schlae/SynchroDriver/SynchroDriverD/SynchroDriverD.pdf

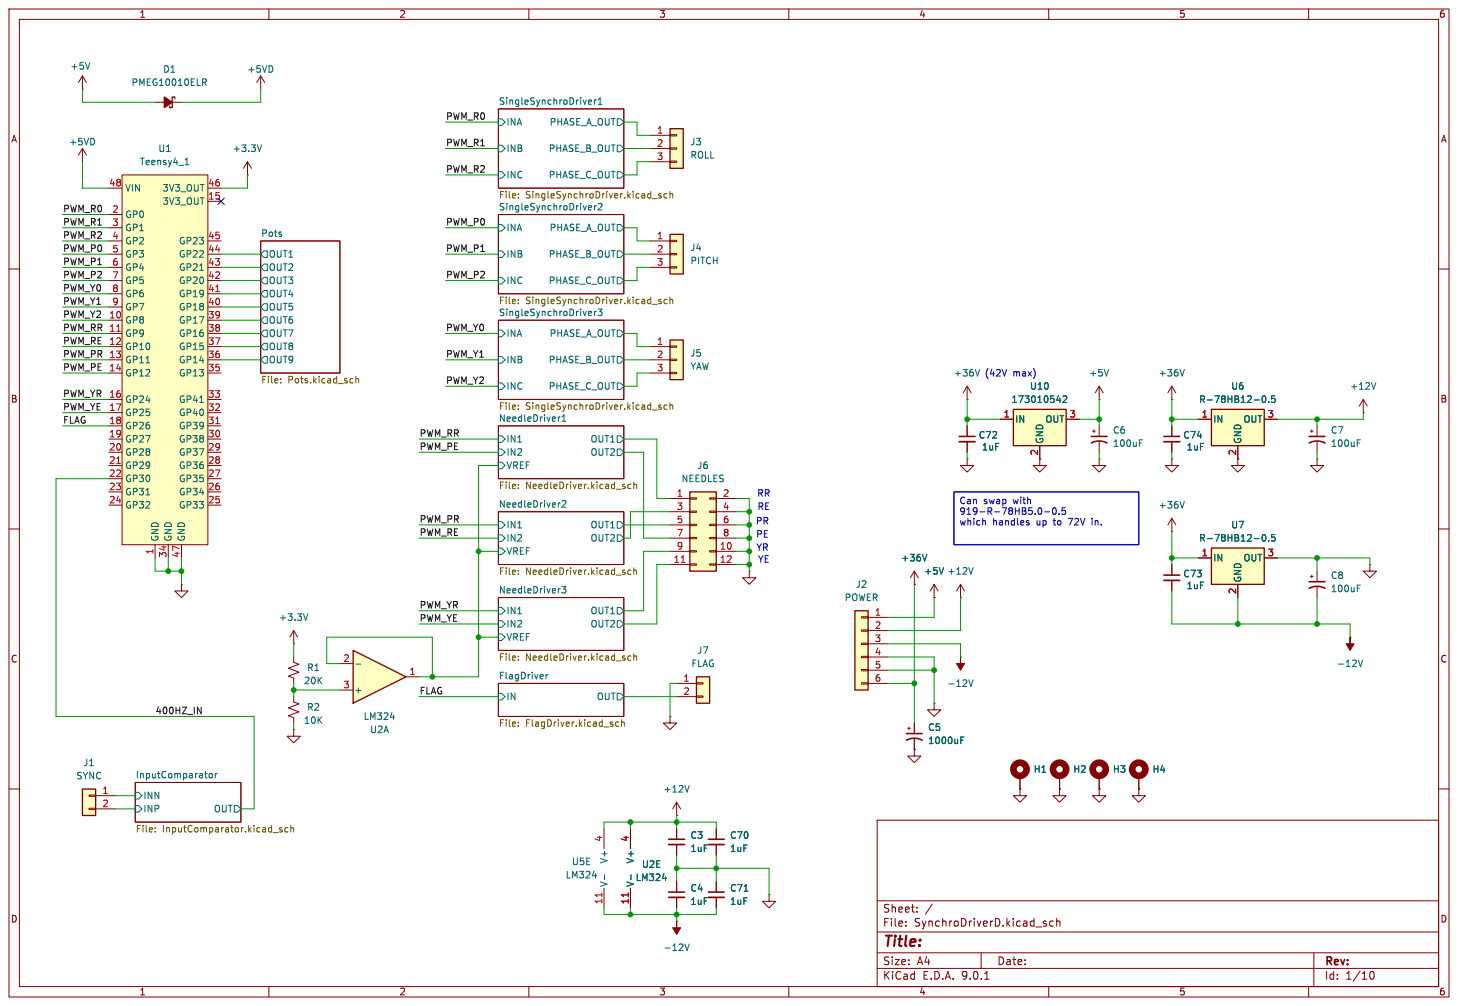
[picture p1: page 1]

919-R-78HB5.0-0.5 which handles up to 72V in. YR

Id: 1/10 Title: File: SynchroDriverD.kicad_sch Sheet: /

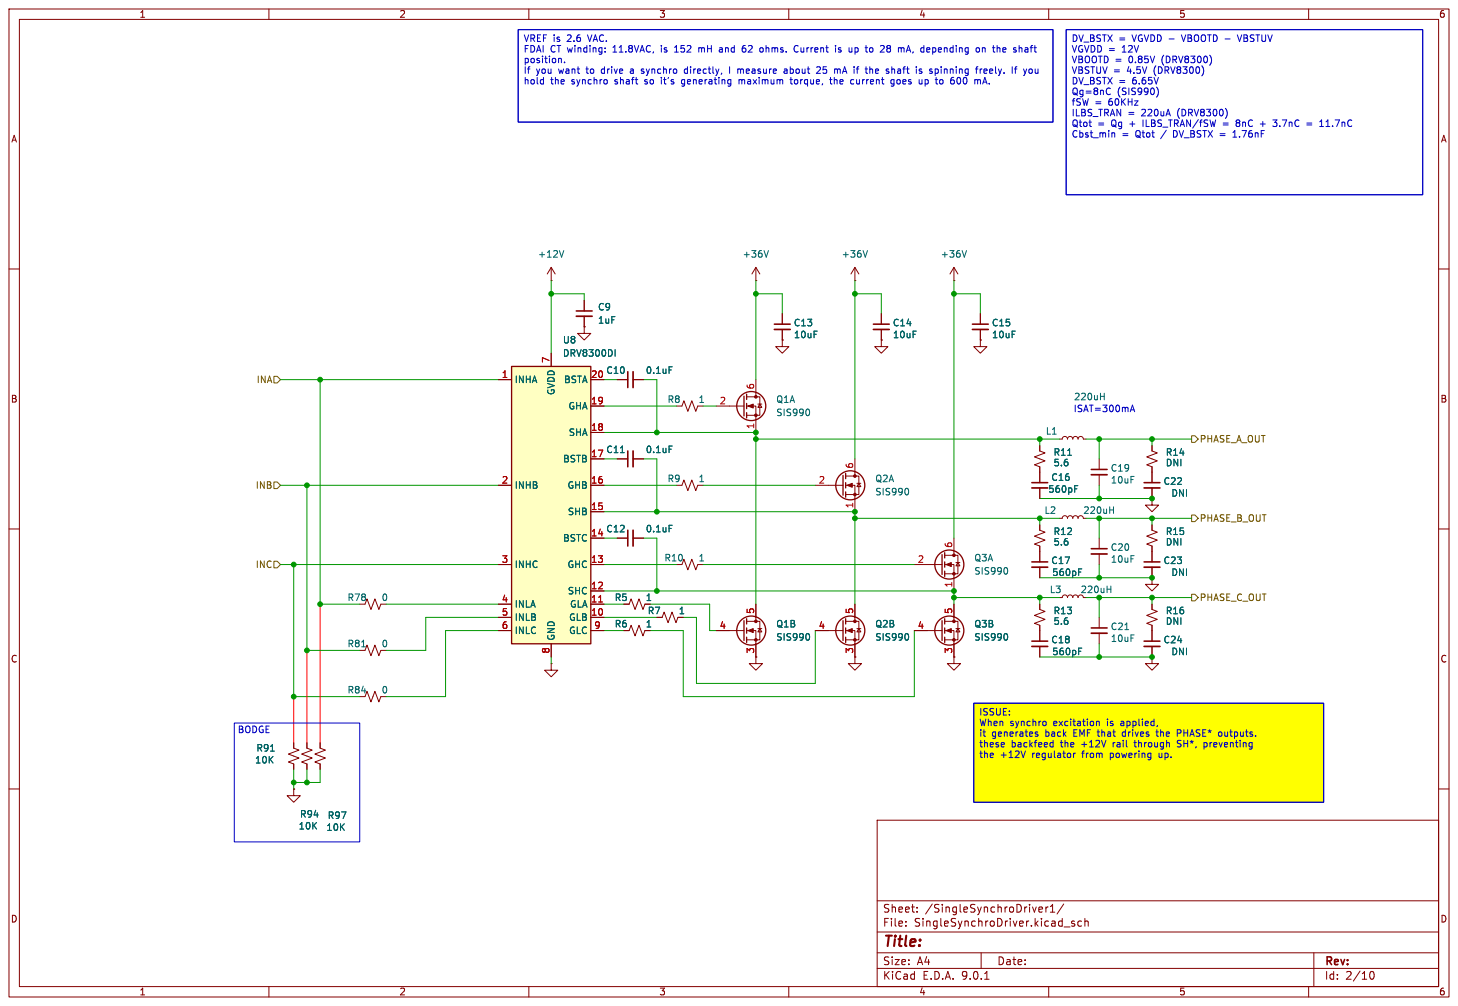
[picture p2: page 2]

8 BSTA 20 GHA 19 SHA 18 BSTB 17 GHB 16 SHB 15 BSTC 14 GHC 13 SHC 12 GLA 11 GLB 10 GLC 9 U8 DRV8300DI L1

8 BSTA 20 GHA 19 SHA 18 BSTB 17 GHB 16 SHB 15 BSTC 14 GHC 13 SHC 12 GLA 11 GLB 10 GLC 9 R94

these backfeed the +12V rail through SH*, preventing

Id: 2/10 Title: File: SingleSynchroDriver.kicad_sch Sheet: /SingleSynchroDriver1/

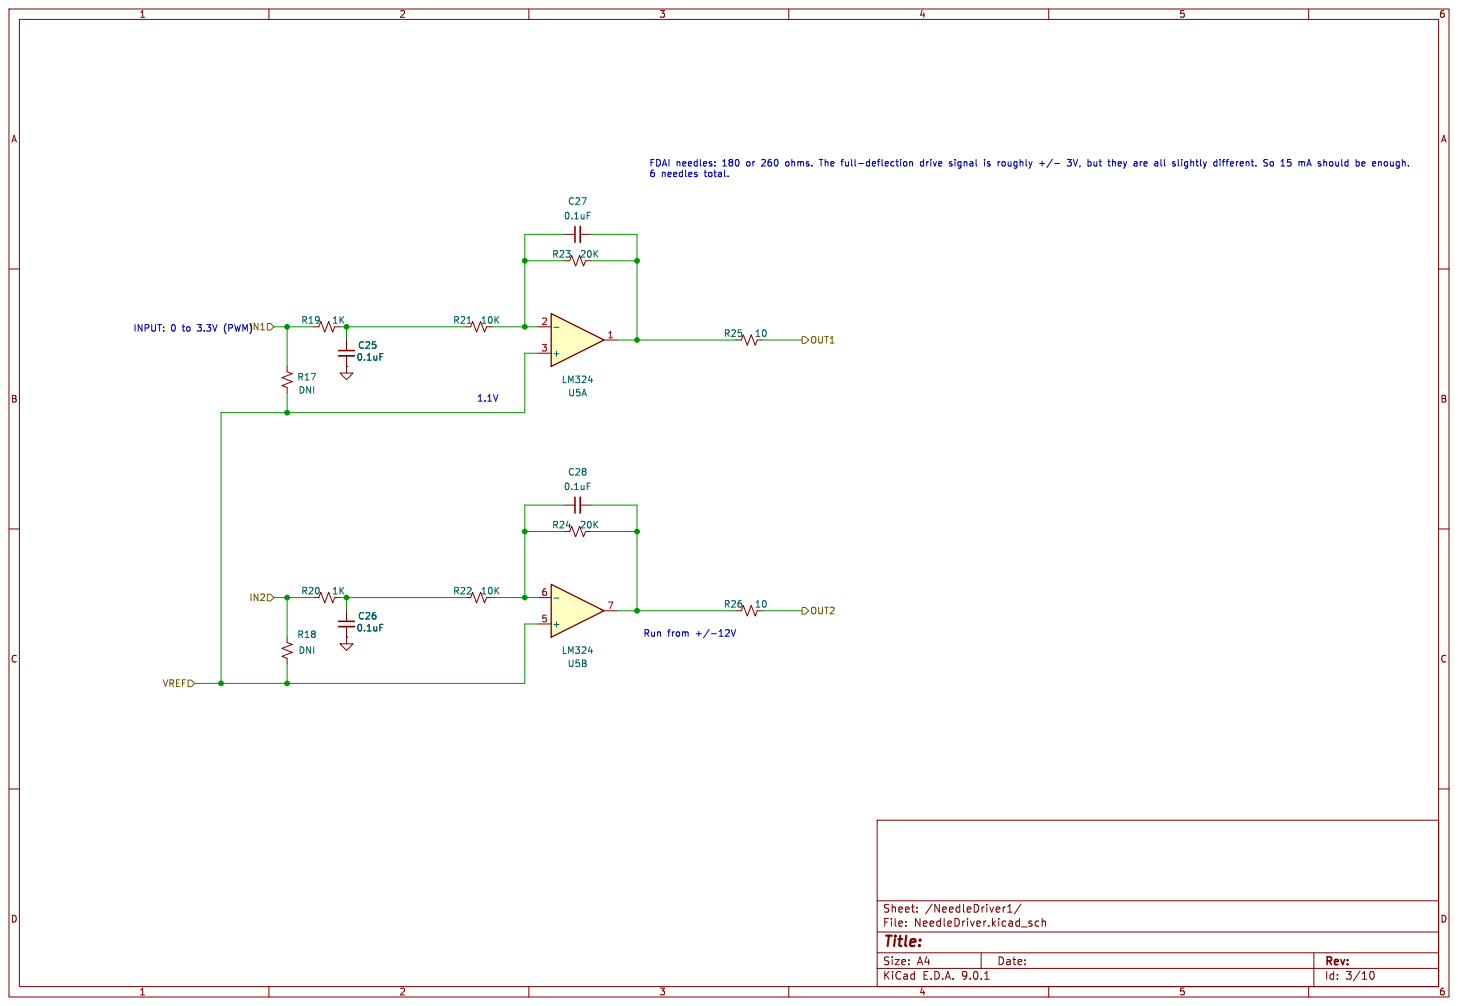
[picture p3: page 3]

Id: 3/10 Title: File: NeedleDriver.kicad_sch Sheet: /NeedleDriver1/

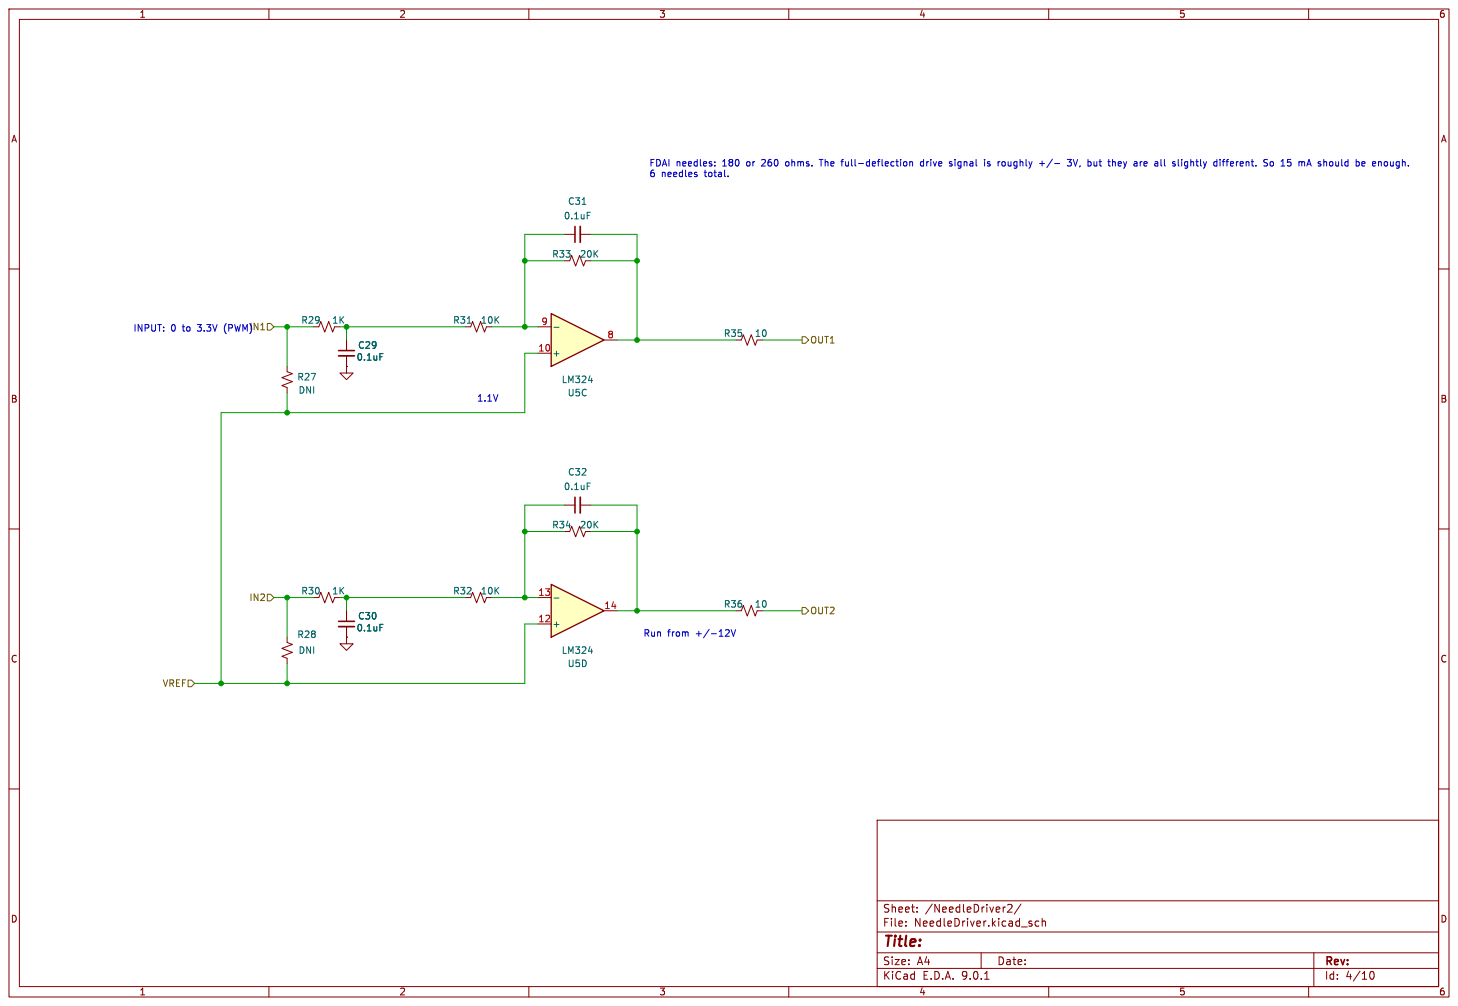
[picture p4: page 4]

Id: 4/10 Title: File: NeedleDriver.kicad_sch Sheet: /NeedleDriver2/

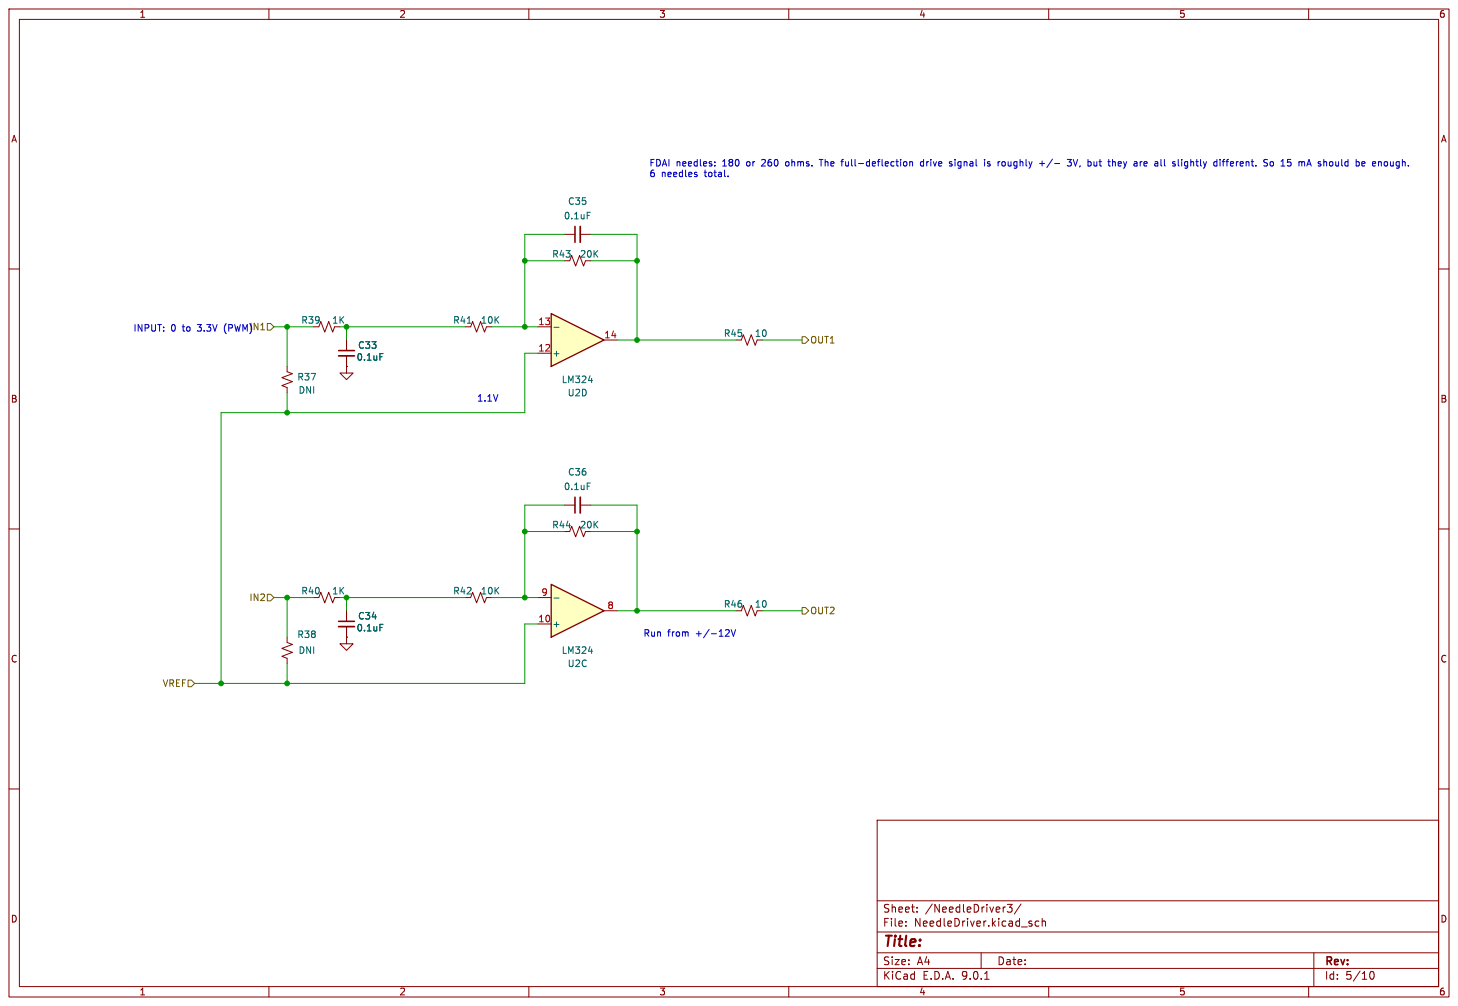
[picture p5: page 5]

Id: 5/10 Title: File: NeedleDriver.kicad_sch Sheet: /NeedleDriver3/

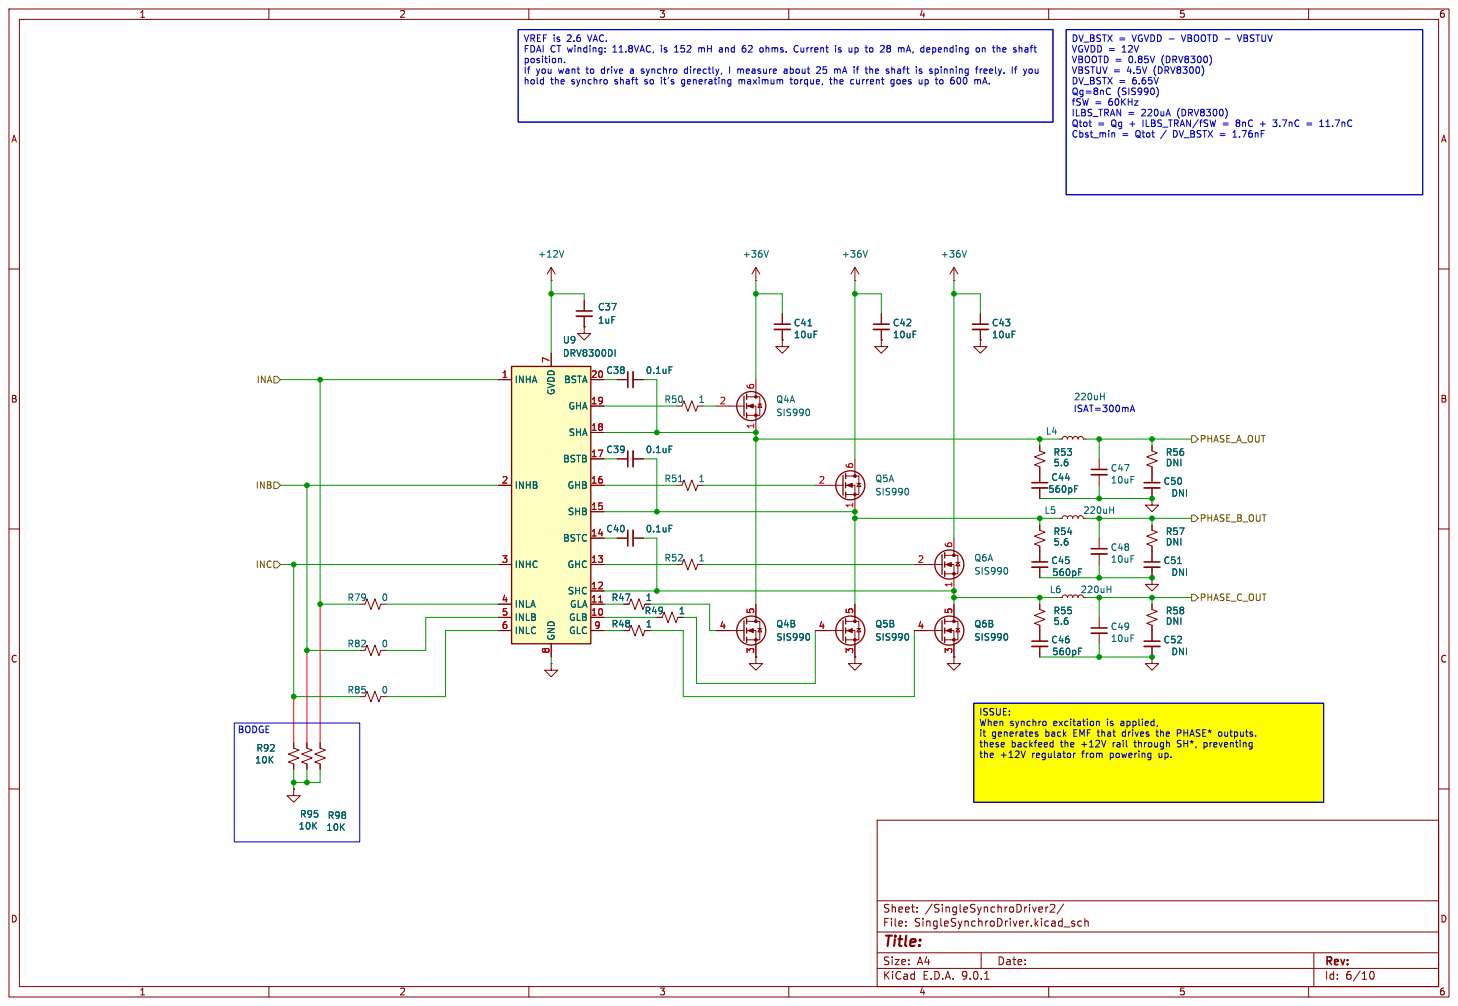
[picture p6: page 6]

8 BSTA 20 GHA 19 SHA 18 BSTB 17 GHB 16 SHB 15 BSTC 14 GHC 13 SHC 12 GLA 11 GLB 10 GLC 9 U9 DRV8300DI L4

8 BSTA 20 GHA 19 SHA 18 BSTB 17 GHB 16 SHB 15 BSTC 14 GHC 13 SHC 12 GLA 11 GLB 10 GLC 9 R95

these backfeed the +12V rail through SH*, preventing

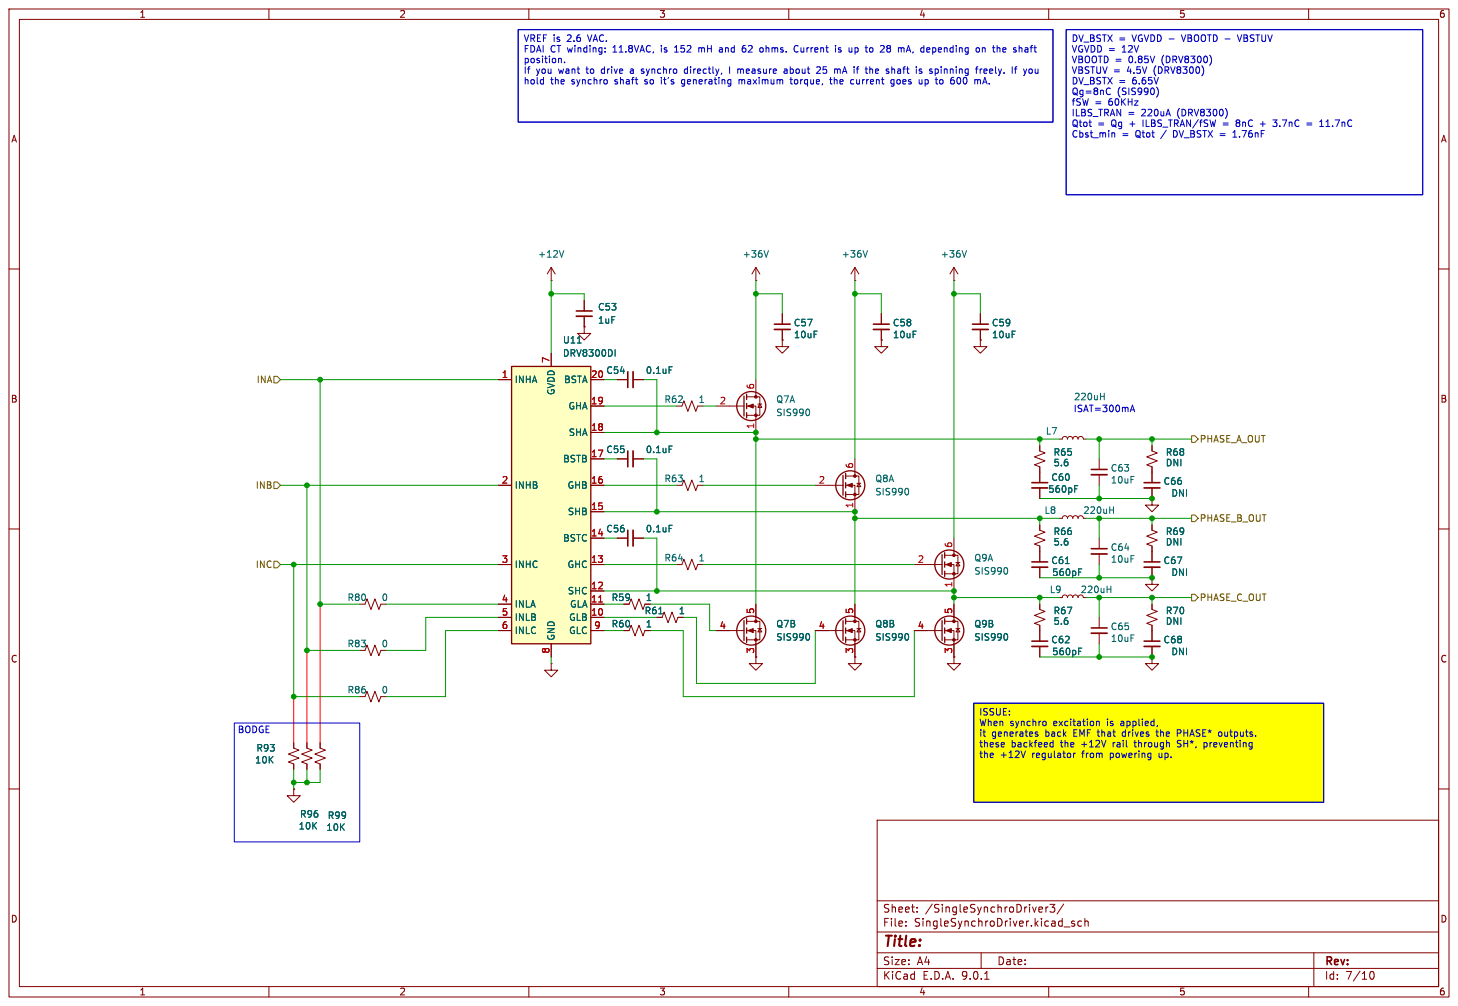
[picture p7: page 7]

8 BSTA 20 GHA 19 SHA 18 BSTB 17 GHB 16 SHB 15 BSTC 14 GHC 13 SHC 12 GLA 11 GLB 10 GLC 9 U11 DRV8300DI L7

8 BSTA 20 GHA 19 SHA 18 BSTB 17 GHB 16 SHB 15 BSTC 14 GHC 13 SHC 12 GLA 11 GLB 10 GLC 9 R96

these backfeed the +12V rail through SH*, preventing

Id: 7/10 Title: File: SingleSynchroDriver.kicad_sch Sheet: /SingleSynchroDriver3/

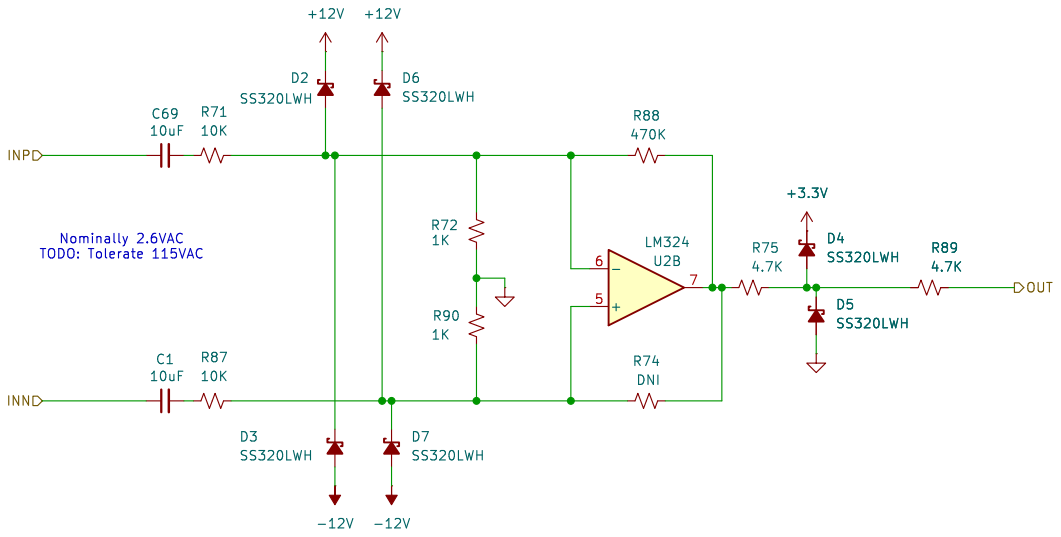
[picture p8: page 8]

Id: 8/10 Title: File: InputComparator.kicad_sch Sheet: /InputComparator/

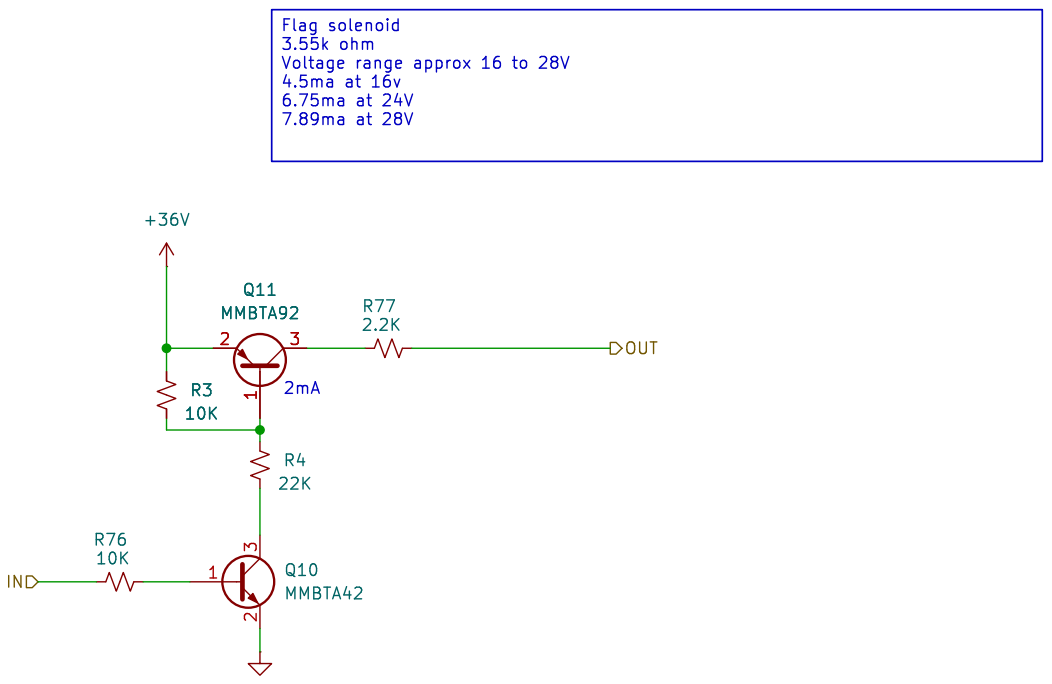
[picture p9: page 9]

Flag solenoid
3.55k ohm
Voltage range approx 16 to 28V

Id: 9/10 Title: File: FlagDriver.kicad_sch Sheet: /FlagDriver/

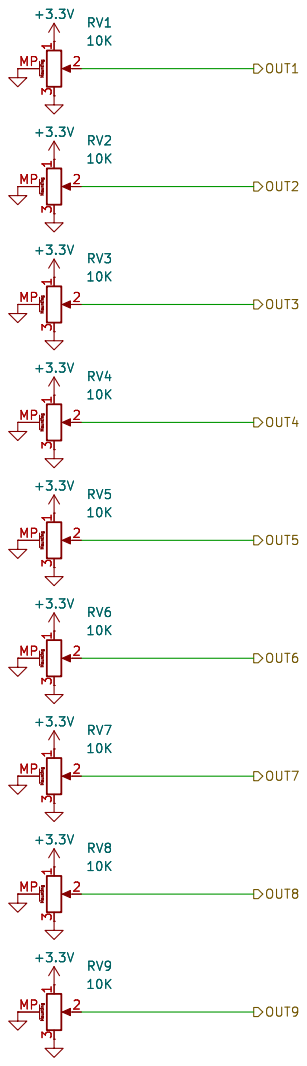
[picture p10: page 10]

Id: 10/10 Title: File: Pots.kicad_sch Sheet: /Pots/
