schlae/SynchroDriver/SynchroDriverDS/SynchroDriverDS.pdf

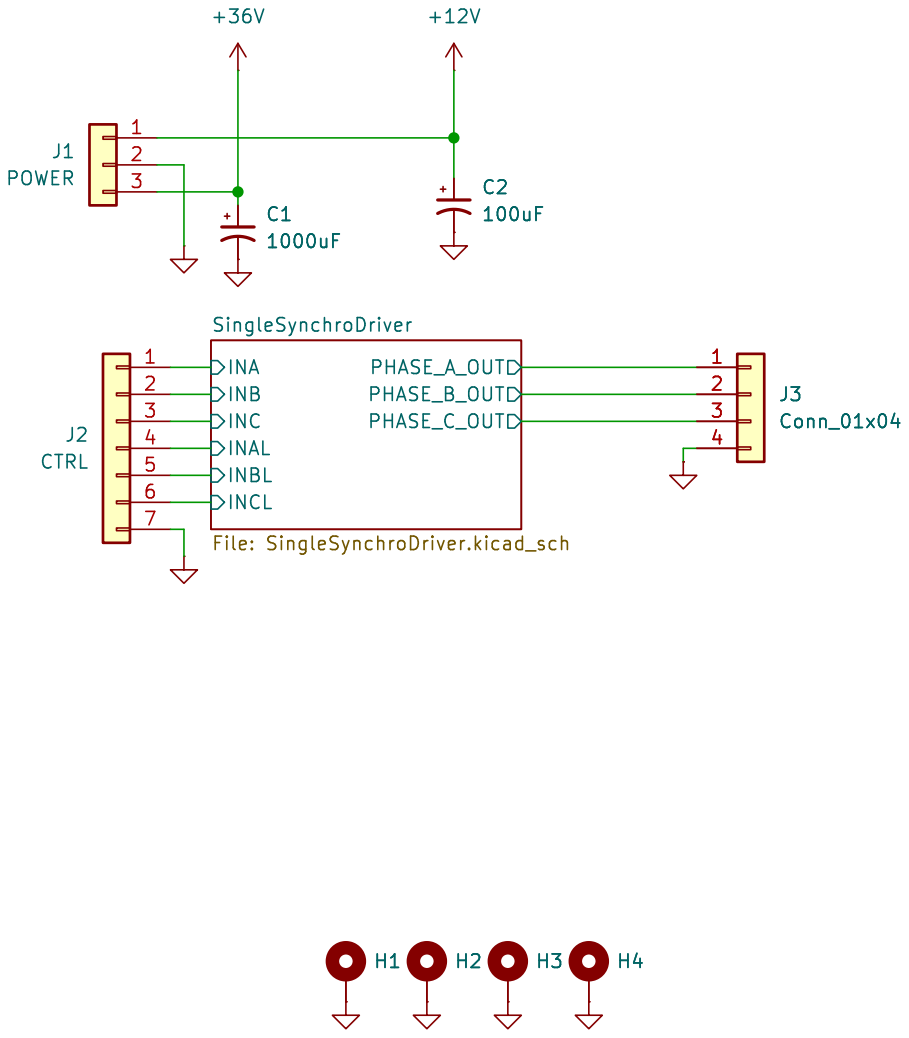
[picture p11: page 1]

INCL SingleSynchroDriver File: SingleSynchroDriver.kicad_sch

2 | 2 2
3 | 3 3

Id: 1/2 Title: File: SynchroDriverDS.kicad_sch Sheet: /

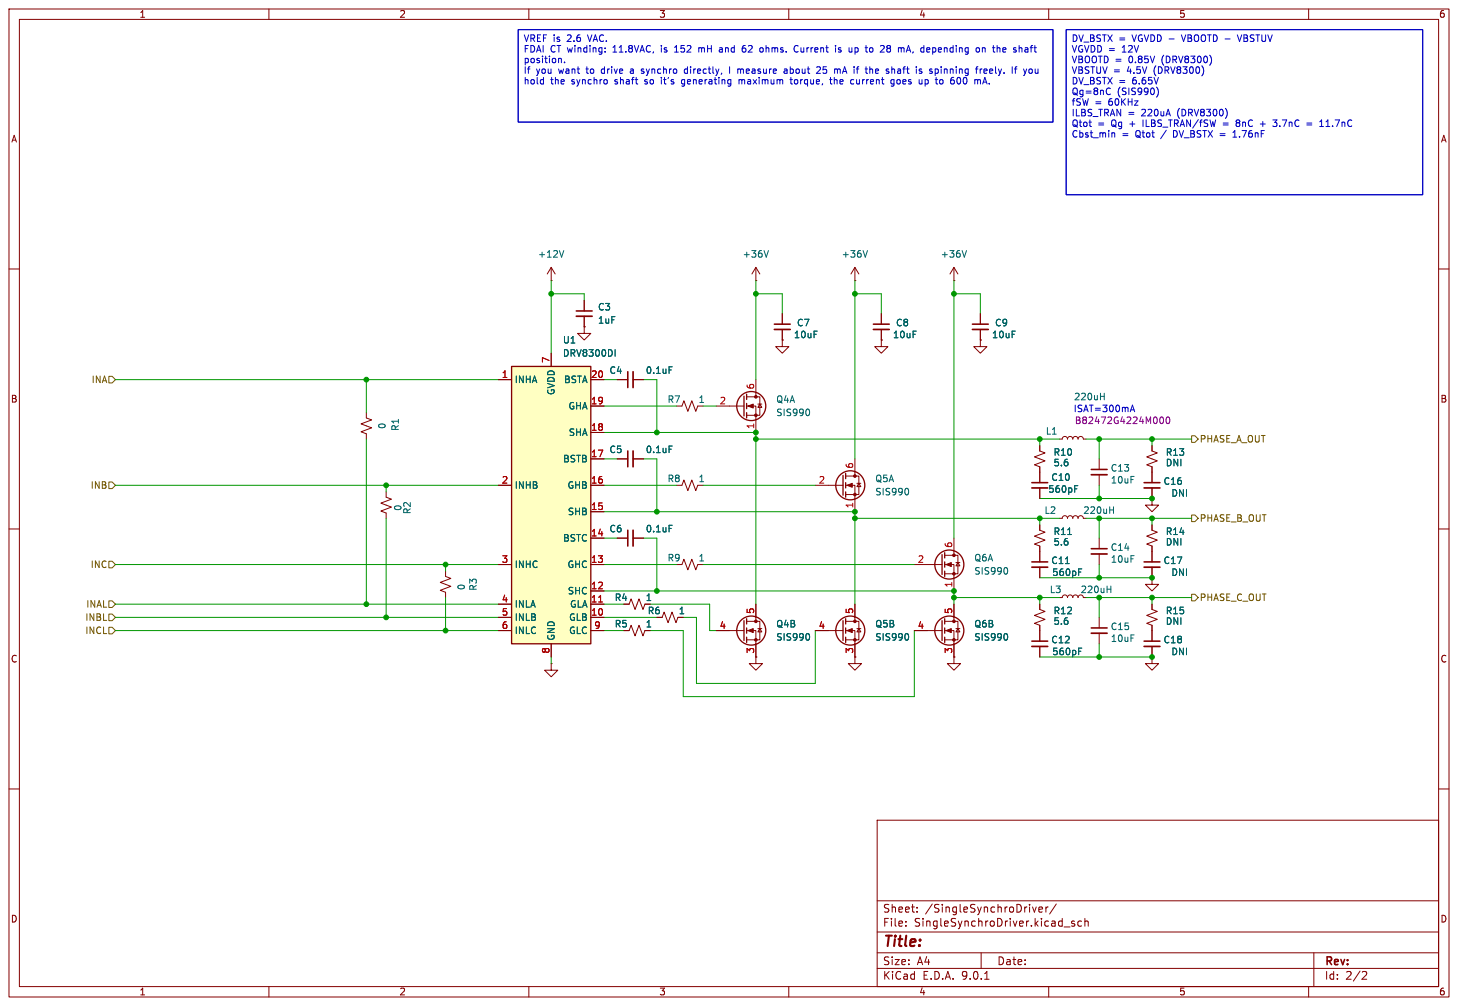
[picture p12: page 2]

8 BSTA 20 GHA 19 SHA 18 BSTB 17 GHB 16 SHB 15 BSTC 14 GHC 13 SHC 12 GLA 11 GLB 10 GLC 9 U1 DRV8300DI C7

8 BSTA 20 GHA 19 SHA 18 BSTB 17 GHB 16 SHB 15 BSTC 14 GHC 13 SHC 12 GLA 11 GLB 10 GLC 9 R11
