schlae/SynchroDriver/SynchroDriverAS/SynchroDriverAS.pdf

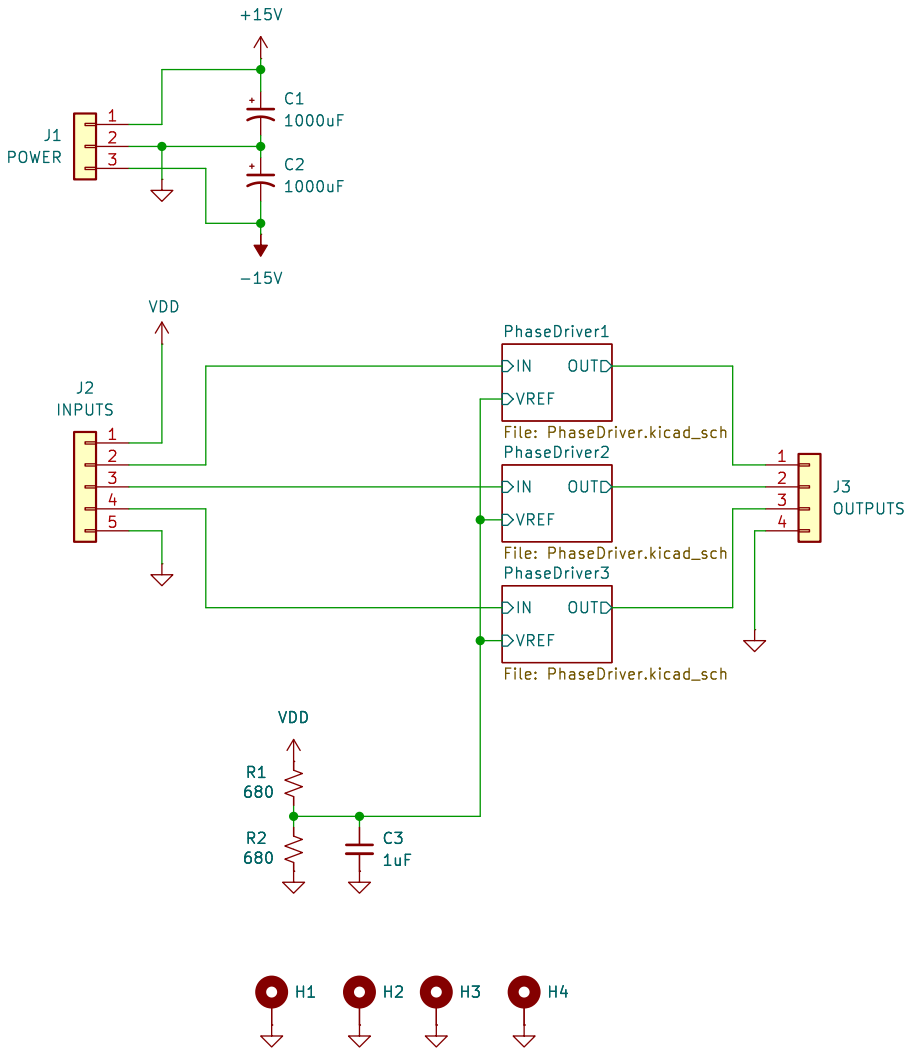
[picture p13: page 1]

Id: 1/4 Title: File: SynchroDriverAS.kicad_sch Sheet: /

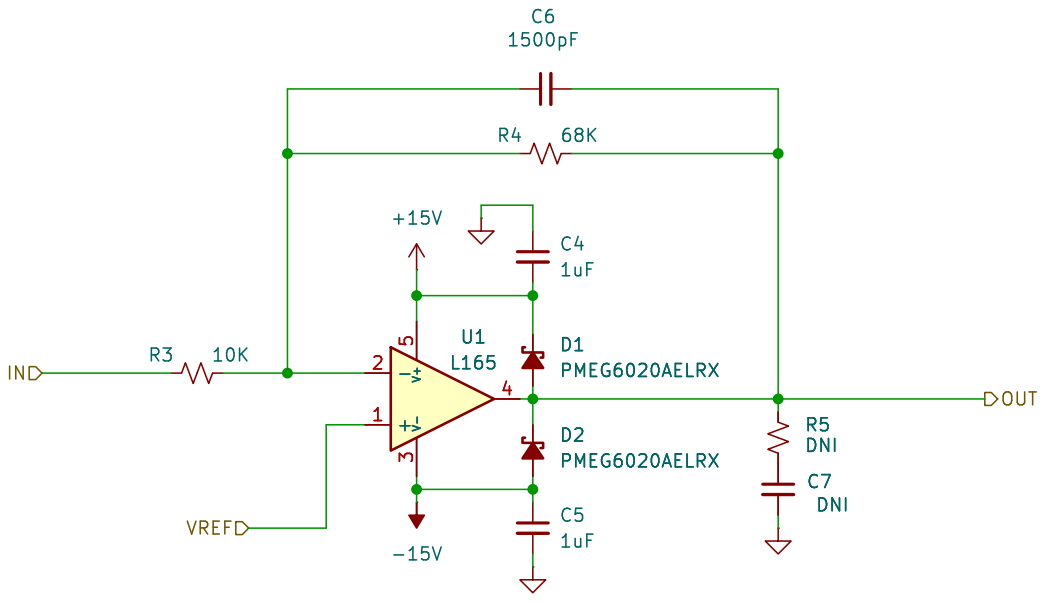
[picture p14: page 2]

Id: 2/4 Title: File: PhaseDriver.kicad_sch Sheet: /PhaseDriver1/

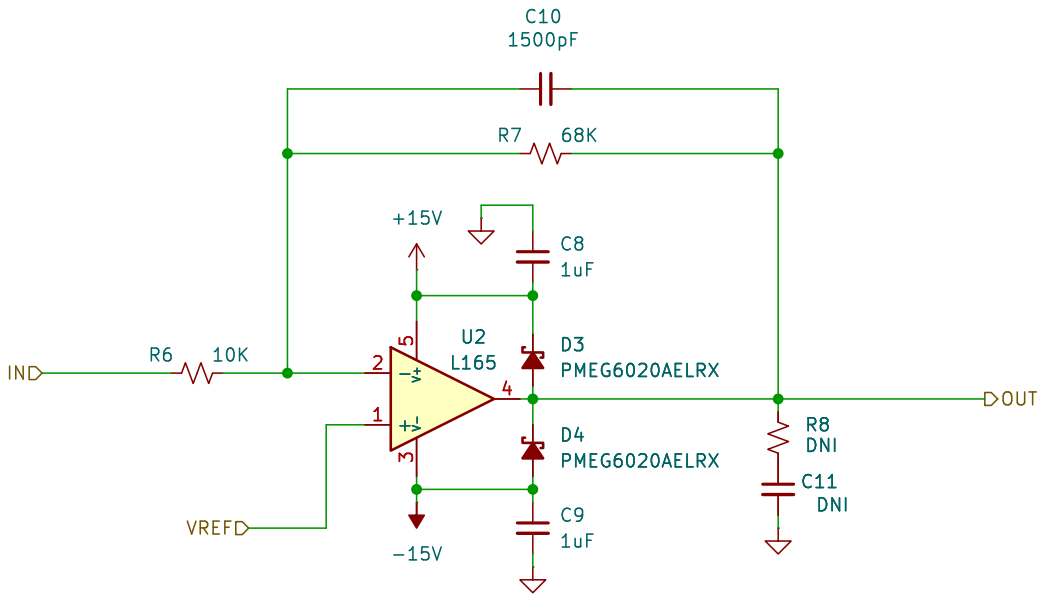
[picture p15: page 3]

Id: 3/4 Title: File: PhaseDriver.kicad_sch Sheet: /PhaseDriver2/

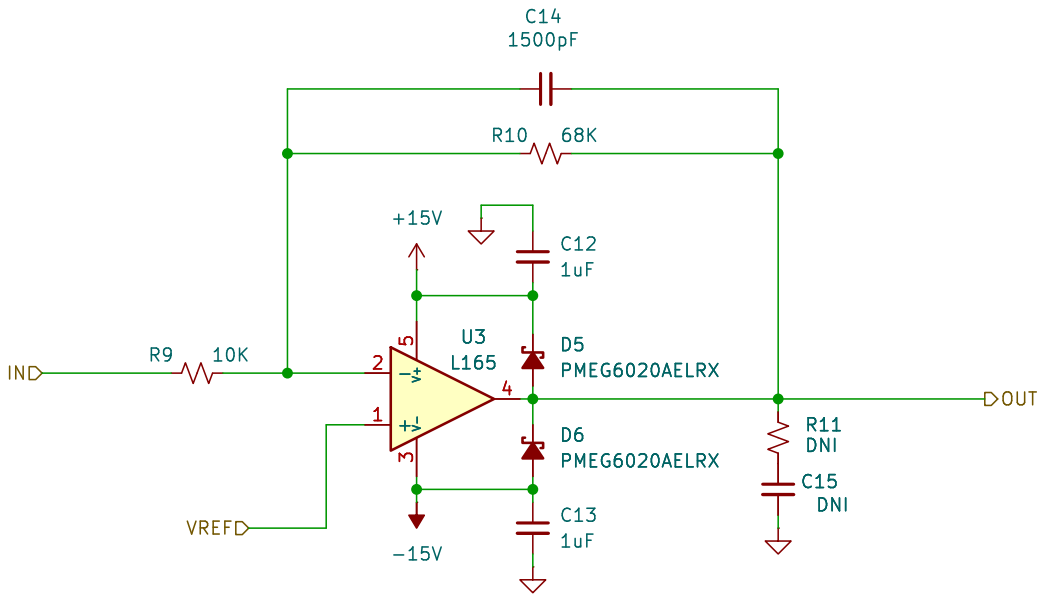
[picture p16: page 4]

Id: 4/4 Title: File: PhaseDriver.kicad_sch Sheet: /PhaseDriver3/
