schlae/SynchroDriver/SynchroDriverD/SynchroDriverD.kicad_pcb

## KiCad design SynchroDriverD/SynchroDriverD.kicad_pcb (2026-11-01)

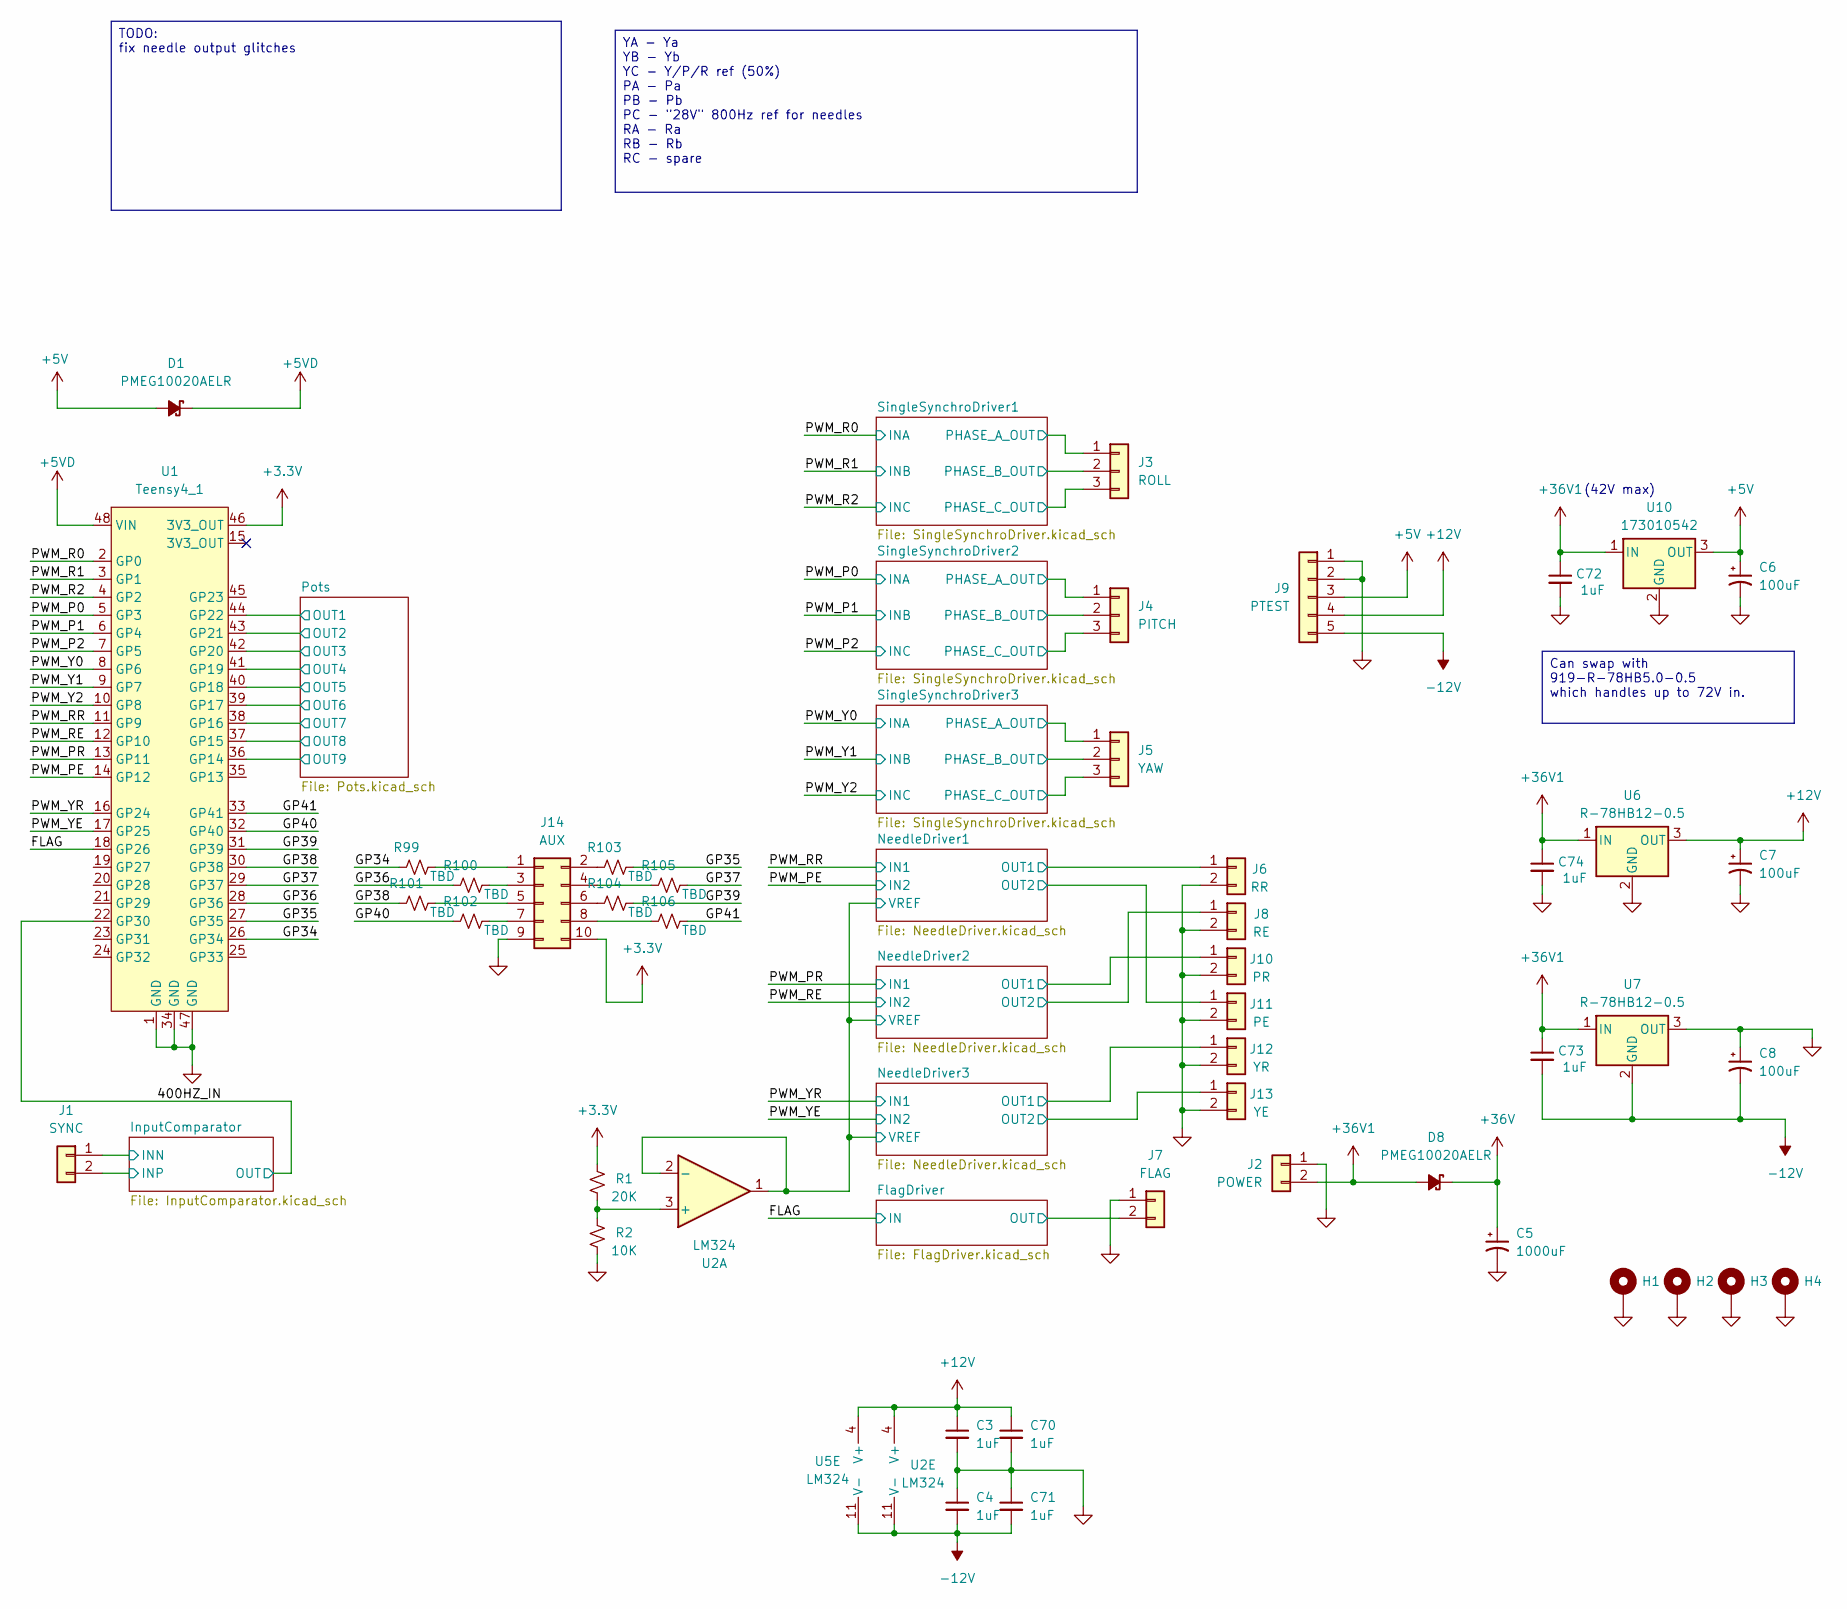
[picture p17: schematic SynchroDriverD.kicad_sch]

Parts:
C3, C4, C70, C71: 1uF; CAPC2012X55
C5: 1000uF; CAPAE500P1000X1500
C6, C7, C8: 100uF; CAPAE350P800X700
C72, C73, C74: 1uF; C_1206_3216Metric; MPN CL31A106KBHNNNE
D1, D8: PMEG10020AELR; SOD3716X117; Mouser 771-PMEG10020AELRX
H1, H2, H3, H4: MountingHole_Pad; MountingHole_3.2mm_M3_DIN965_Pad
J1: SYNC; PinHeader_1x02_P2.54mm_Vertical
J2: POWER; TE_826576-2_1x02_P3.96mm_Vertical
J3: ROLL; PinHeader_1x03_P2.54mm_Vertical
J4: PITCH; PinHeader_1x03_P2.54mm_Vertical
J5: YAW; PinHeader_1x03_P2.54mm_Vertical
J6: RR; PinHeader_1x02_P2.54mm_Vertical
J7: FLAG; PinHeader_1x02_P2.54mm_Vertical
J8: RE; PinHeader_1x02_P2.54mm_Vertical
J9: PTEST; TE_826576-5_1x05_P3.96mm_Vertical
J10: PR; PinHeader_1x02_P2.54mm_Vertical
J11: PE; PinHeader_1x02_P2.54mm_Vertical
J12: YR; PinHeader_1x02_P2.54mm_Vertical
J13: YE; PinHeader_1x02_P2.54mm_Vertical
J14: AUX; PinHeader_2x05_P2.54mm_Vertical
R1: 20K; RESC1608X55
R2: 10K; RESC1608X55
R99, R100, R101, R102, R103, R104, R105, R106: TBD; RESC1608X55
U1: Teensy4_1; DIP-48_W15.24mm_Socket
U2, U5: LM324; SOP127P620X175-14; Mouser 863-LM324DR2G
U6, U7: R-78HB12-0.5; DCDC_3PIN_GENERIC_SHIFTED; Mouser 919-R-78HB12-0.5
U10: 173010542; DCDC_3PIN_GENERIC; Mouser 710-173010542

Connections:
+3.3V: J14.10, R1.2, U1.46 (3V3_OUT); also elsewhere on the board
+5V: C6.1, D1.2 (A), J9.3, U10.3 (OUT); also elsewhere on the board
+5VD: D1.1 (K), U1.48 (VIN)
+12V: C3.1, C7.1, C70.1, J9.4, U2.4 (V+), U5.4 (V+), U6.3 (OUT); also elsewhere on the board
+36V: C5.1, D8.1 (K); also elsewhere on the board
+36V1: C72.1, C73.1, C74.1, D8.2 (A), J2.2, U6.1 (IN), U7.1 (IN), U10.1 (IN); also elsewhere on the board
-12V: C4.2, C8.2, C71.2, C73.2, J9.5, U2.11 (V-), U5.11 (V-), U7.2 (GND); also elsewhere on the board
/400HZ_IN: U1.22 (GP30); also elsewhere on the board
/FLAG: U1.18 (GP26); also elsewhere on the board
/FlagDriver/OUT: J7.2; also elsewhere on the board
/GP34: R99.2, U1.26 (GP34)
/GP35: R103.1, U1.27 (GP35)
/GP36: R100.2, U1.28 (GP36)
/GP37: R105.1, U1.29 (GP37)
/GP38: R101.2, U1.30 (GP38)
/GP39: R104.1, U1.31 (GP39)
/GP40: R102.2, U1.32 (GP40)
/GP41: R106.1, U1.33 (GP41)
/InputComparator/INN: J1.1; also elsewhere on the board
/InputComparator/INP: J1.2; also elsewhere on the board
/NeedleDriver1/OUT1: J6.1; also elsewhere on the board
/NeedleDriver1/OUT2: J11.1; also elsewhere on the board
/NeedleDriver1/VREF: U2.1, U2.2 (-), U2.10 (+), U2.12 (+), U5.10 (+), U5.12 (+); also elsewhere on the board
/NeedleDriver2/OUT1: J10.1; also elsewhere on the board
/NeedleDriver2/OUT2: J8.1; also elsewhere on the board
/NeedleDriver3/OUT1: J12.1; also elsewhere on the board
/NeedleDriver3/OUT2: J13.1; also elsewhere on the board
/PWM_P0: U1.5 (GP3); also elsewhere on the board
/PWM_P1: U1.6 (GP4); also elsewhere on the board
/PWM_P2: U1.7 (GP5); also elsewhere on the board
/PWM_PE: U1.14 (GP12); also elsewhere on the board
/PWM_PR: U1.13 (GP11); also elsewhere on the board
/PWM_R0: U1.2 (GP0); also elsewhere on the board
/PWM_R1: U1.3 (GP1); also elsewhere on the board
/PWM_R2: U1.4 (GP2); also elsewhere on the board
/PWM_RE: U1.12 (GP10); also elsewhere on the board
/PWM_RR: U1.11 (GP9); also elsewhere on the board
/PWM_Y0: U1.8 (GP6); also elsewhere on the board
/PWM_Y1: U1.9 (GP7); also elsewhere on the board
/PWM_Y2: U1.10 (GP8); also elsewhere on the board
/PWM_YE: U1.17 (GP25); also elsewhere on the board
/PWM_YR: U1.16 (GP24); also elsewhere on the board
/Pots/OUT1: U1.44 (GP22); also elsewhere on the board
/Pots/OUT2: U1.43 (GP21); also elsewhere on the board
/Pots/OUT3: U1.42 (GP20); also elsewhere on the board
/Pots/OUT4: U1.41 (GP19); also elsewhere on the board
/Pots/OUT5: U1.40 (GP18); also elsewhere on the board
/Pots/OUT6: U1.39 (GP17); also elsewhere on the board
/Pots/OUT7: U1.38 (GP16); also elsewhere on the board
/Pots/OUT8: U1.37 (GP15); also elsewhere on the board
/Pots/OUT9: U1.36 (GP14); also elsewhere on the board
/SingleSynchroDriver1/PHASE_A_OUT: J3.1; also elsewhere on the board
/SingleSynchroDriver1/PHASE_B_OUT: J3.2; also elsewhere on the board
/SingleSynchroDriver1/PHASE_C_OUT: J3.3; also elsewhere on the board
/SingleSynchroDriver2/PHASE_A_OUT: J4.1; also elsewhere on the board
/SingleSynchroDriver2/PHASE_B_OUT: J4.2; also elsewhere on the board
/SingleSynchroDriver2/PHASE_C_OUT: J4.3; also elsewhere on the board
/SingleSynchroDriver3/PHASE_A_OUT: J5.1; also elsewhere on the board
/SingleSynchroDriver3/PHASE_B_OUT: J5.2; also elsewhere on the board
/SingleSynchroDriver3/PHASE_C_OUT: J5.3; also elsewhere on the board
GND: C3.2, C4.1, C5.2, C6.2, C7.2, C8.1, C70.2, C71.1, C72.2, C74.2, H1.1, H2.1, H3.1, H4.1, J2.1, J6.2, J7.1, J8.2, J9.1, J9.2, J10.2, J11.2, J12.2, J13.2, J14.9, R2.1, U1.1 (GND), U1.34 (GND), U1.47 (GND), U6.2 (GND), U7.3 (OUT), U10.2 (GND); also elsewhere on the board
unnamed 77: U5.8; also elsewhere on the board
unnamed 78: U5.14; also elsewhere on the board
unnamed 81: U2.14; also elsewhere on the board
unnamed 82: U2.8; also elsewhere on the board
unnamed: J14.1, R99.1
unnamed: J14.2, R103.2
unnamed: J14.3, R100.1
unnamed: J14.4, R105.2
unnamed: J14.5, R101.1
unnamed: J14.6, R104.2
unnamed: J14.7, R102.1
unnamed: J14.8, R106.2
unnamed: R1.1, R2.2, U2.3 (+)
unnamed 140: U2.9 (-); also elsewhere on the board
unnamed 141: U2.13 (-); also elsewhere on the board
unnamed 144: U5.9 (-); also elsewhere on the board
unnamed 145: U5.13 (-); also elsewhere on the board

Notes on the sheet:
(42V max)
Can swap with 919-R-78HB5.0-0.5 which handles up to 72V in.
YA - Ya YB - Yb YC - Y/P/R ref (50%) PA - Pa PB - Pb PC - "28V" 800Hz ref for needles RA - Ra RB - Rb RC - spare
TODO: fix needle output glitches

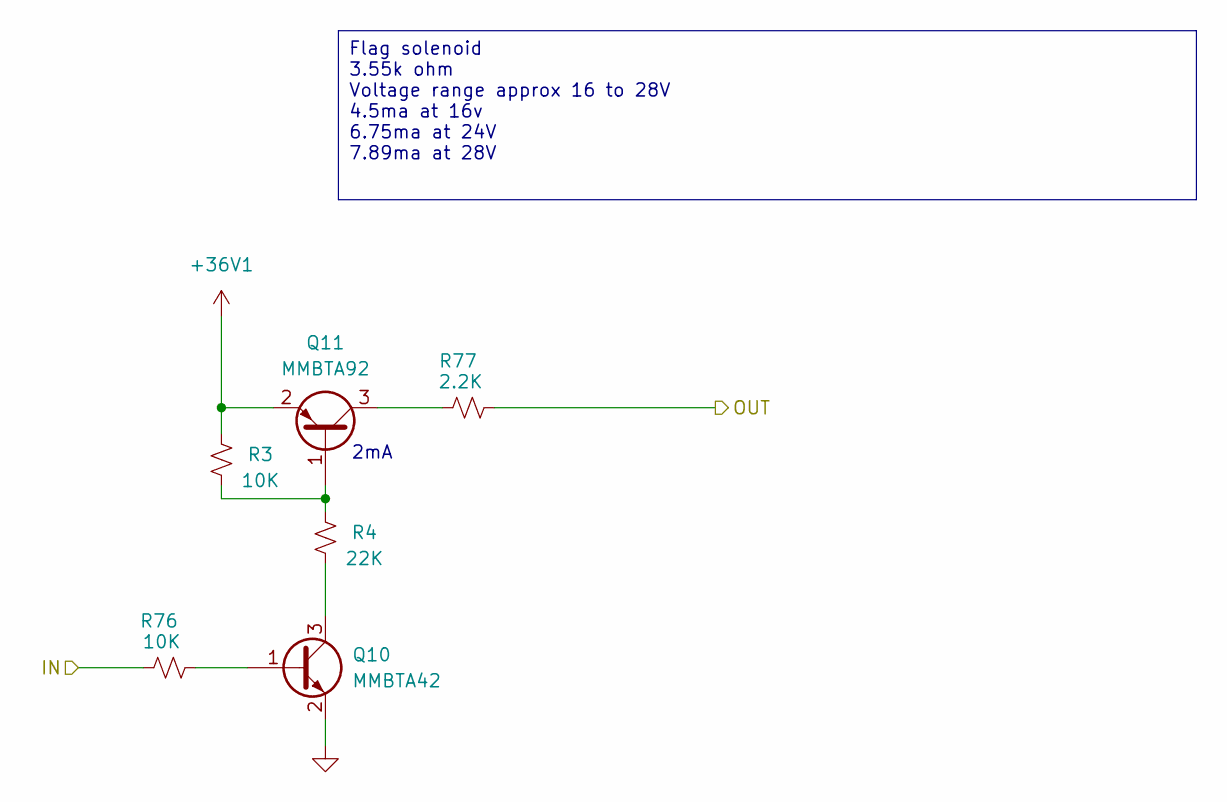
[picture p18: schematic FlagDriver.kicad_sch]

Parts:
Q10: MMBTA42; SOT-23; Mouser 637-MMBTA42
Q11: MMBTA92; SOT-23; Mouser 637-MMBTA92
R3, R76: 10K; R_0603_1608Metric
R4: 22K; R_0603_1608Metric
R77: 2.2K; R_0603_1608Metric

Connections:
+36V1: Q11.2 (E), R3.2; also elsewhere on the board
/FLAG: R76.2; also elsewhere on the board
/FlagDriver/OUT: R77.1; also elsewhere on the board
GND: Q10.2 (E); also elsewhere on the board
unnamed: Q10.1 (B), R76.1
unnamed: Q10.3 (C), R4.1
unnamed: Q11.1 (B), R3.1, R4.2
unnamed: Q11.3 (C), R77.2

Notes on the sheet:
2mA
Flag solenoid 3.55k ohm Voltage range approx 16 to 28V 4.5ma at 16v 6.75ma at 24V 7.89ma at 28V

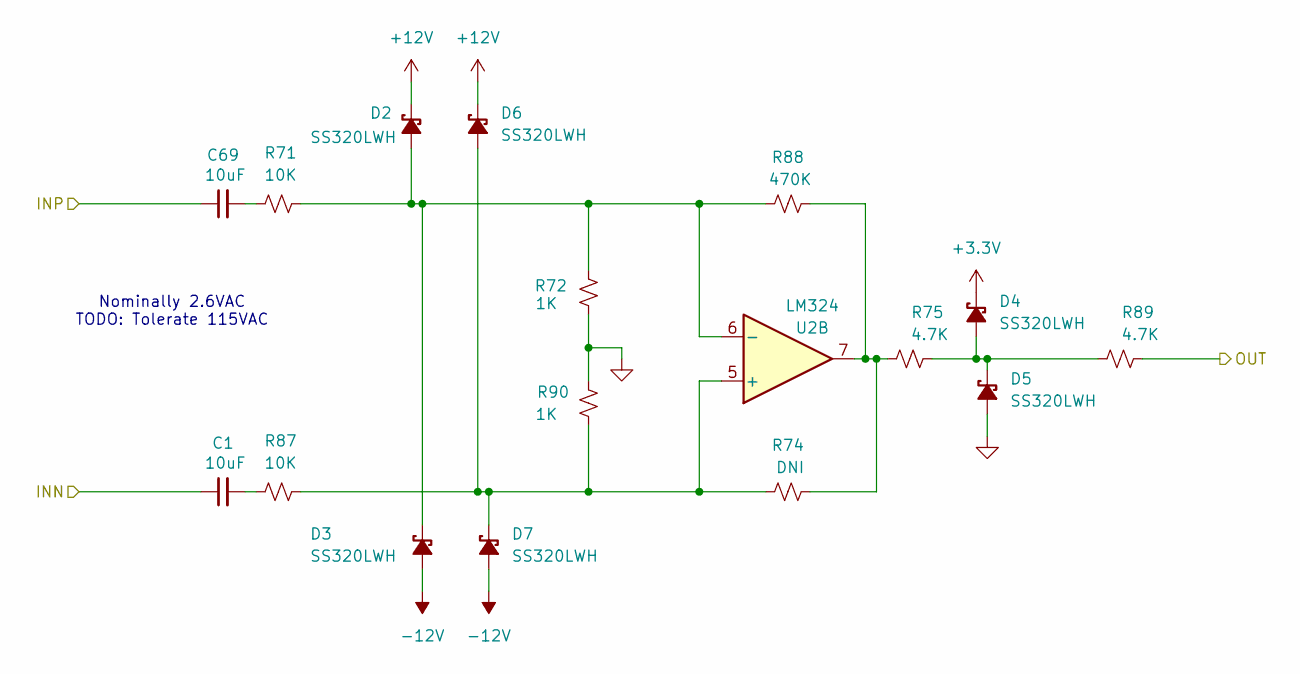
[picture p19: schematic InputComparator.kicad_sch]

Parts:
C1, C69: 10uF; C_1206_3216Metric; MPN CL31A106KBHNNNE; Mouser 187-CL31A106KBHNNNE
D2, D3, D4, D5, D6, D7: SS320LWH; SOD3716X117; Mouser 821-SS320LWH
R71, R87: 10K; RESC3216X70
R72, R90: 1K; RESC1608X55
R74: DNI; RESC1608X55
R75, R89: 4.7K; RESC1608X55
R88: 470K; RESC1608X55
U2: LM324; SOP127P620X175-14; Mouser 863-LM324DR2G

Connections:
+3.3V: D4.1 (K); also elsewhere on the board
+12V: D2.1 (K), D6.1 (K); also elsewhere on the board
-12V: D3.2 (A), D7.2 (A); also elsewhere on the board
/400HZ_IN: R89.1; also elsewhere on the board
/InputComparator/INN: C1.1; also elsewhere on the board
/InputComparator/INP: C69.1; also elsewhere on the board
/NeedleDriver1/VREF: U2.10 (+), U2.12 (+); also elsewhere on the board
GND: D5.2 (A), R72.2, R90.1; also elsewhere on the board
unnamed: C1.2, R87.1
unnamed 81: U2.14; also elsewhere on the board
unnamed 82: U2.8; also elsewhere on the board
unnamed: C69.2, R71.1
unnamed: D2.2 (A), D3.1 (K), R71.2, R72.1, R88.2, U2.6 (-)
unnamed: D4.2 (A), D5.1 (K), R75.1, R89.2
unnamed: D6.2 (A), D7.1 (K), R74.2, R87.2, R90.2, U2.5 (+)
unnamed: R74.1, R75.2, R88.1, U2.7
unnamed 140: U2.9 (-); also elsewhere on the board
unnamed 141: U2.13 (-); also elsewhere on the board

Notes on the sheet:
Nominally 2.6VAC TODO: Tolerate 115VAC

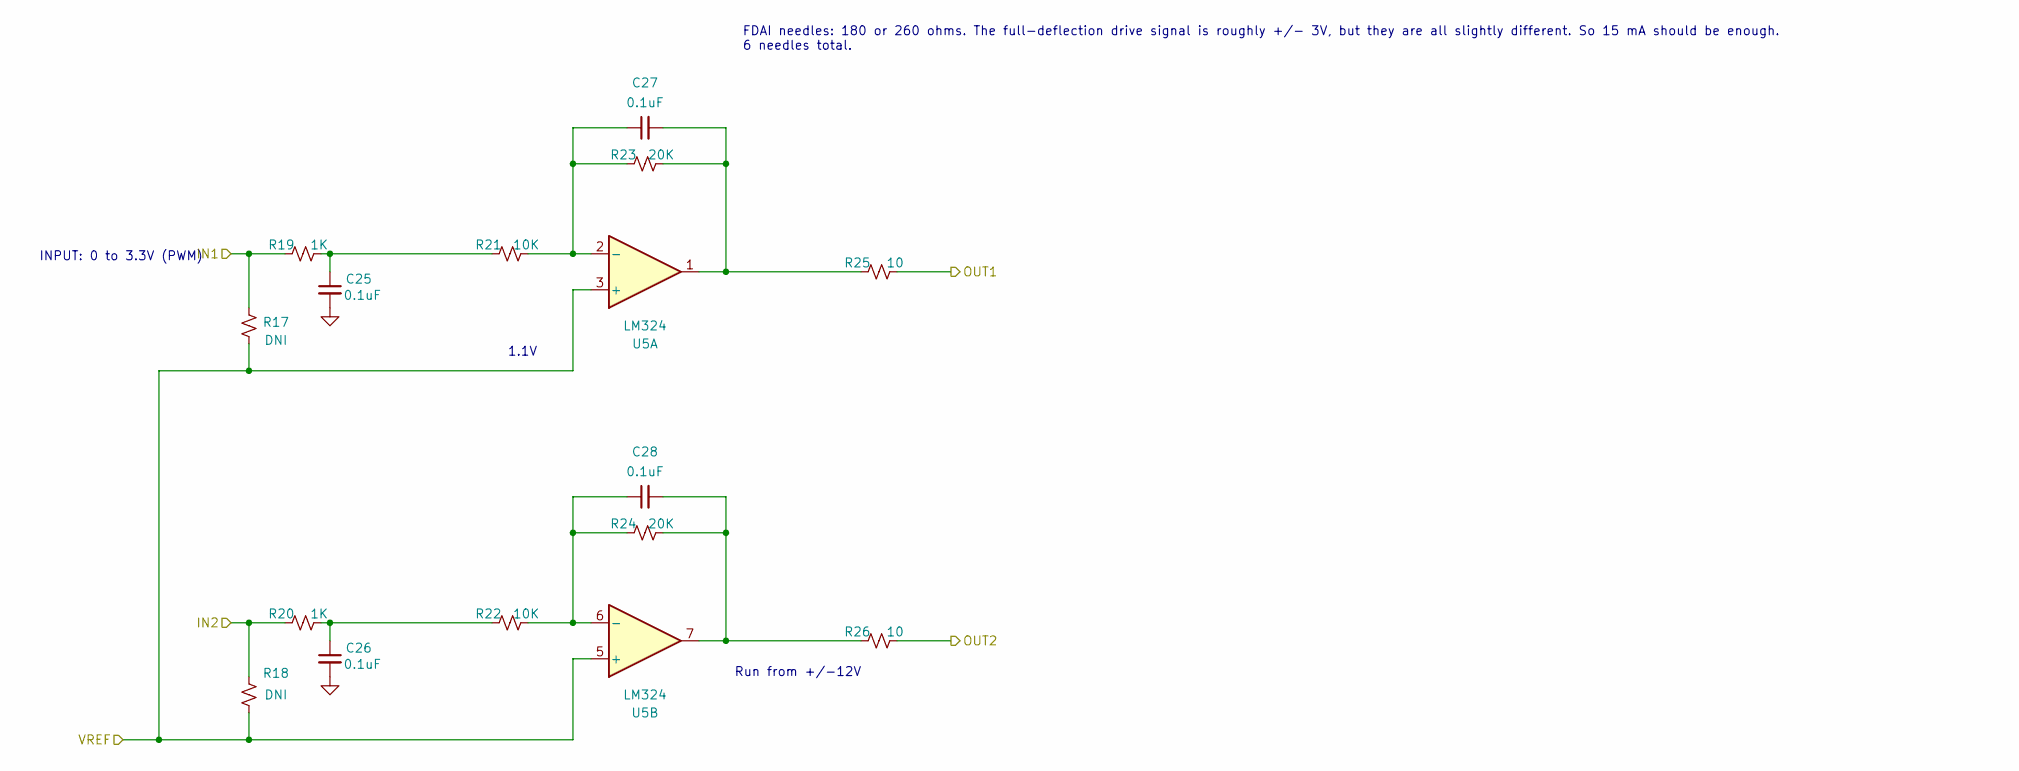
[picture p20: schematic NeedleDriver.kicad_sch]

Parts:
C25, C26, C27, C28: 0.1uF; CAPC1608X100
R17, R18: DNI; RESC1608X55
R19, R20: 1K; RESC1608X55
R21, R22: 10K; RESC1608X55
R23, R24: 20K; RESC1608X55
R25, R26: 10; RESC1608X55
U5: LM324; SOP127P620X175-14; Mouser 863-LM324DR2G

Connections:
/NeedleDriver1/OUT1: R25.2; also elsewhere on the board
/NeedleDriver1/OUT2: R26.2; also elsewhere on the board
/NeedleDriver1/VREF: R17.1, R18.1, U5.3 (+), U5.5 (+), U5.10 (+), U5.12 (+); also elsewhere on the board
/PWM_PE: R18.2, R20.1; also elsewhere on the board
/PWM_RR: R17.2, R19.1; also elsewhere on the board
GND: C25.2, C26.2; also elsewhere on the board
unnamed: C25.1, R19.2, R21.1
unnamed: C26.1, R20.2, R22.1
unnamed: C27.2, R23.2, R25.1, U5.1
unnamed: C28.2, R24.2, R26.1, U5.7
unnamed 77: U5.8; also elsewhere on the board
unnamed 78: U5.14; also elsewhere on the board
unnamed: C27.1, R21.2, R23.1, U5.2 (-)
unnamed: C28.1, R22.2, R24.1, U5.6 (-)
unnamed 144: U5.9 (-); also elsewhere on the board
unnamed 145: U5.13 (-); also elsewhere on the board

Parts of its further copies:
C29, C30, C31, C32, C33, C34, C35, C36: 0.1uF; CAPC1608X100
R27, R28, R37, R38: DNI; RESC1608X55
R29, R30, R39, R40: 1K; RESC1608X55
R31, R32, R41, R42: 10K; RESC1608X55
R33, R34, R43, R44: 20K; RESC1608X55
R35, R36, R45, R46: 10; RESC1608X55

Connections of its further copies:
/NeedleDriver1/VREF: R27.1, R28.1, R37.1, R38.1; also elsewhere on the board
/NeedleDriver2/OUT1: R35.2; also elsewhere on the board
/NeedleDriver2/OUT2: R36.2; also elsewhere on the board
/NeedleDriver3/OUT1: R45.2; also elsewhere on the board
/NeedleDriver3/OUT2: R46.2; also elsewhere on the board
/PWM_PR: R27.2, R29.1; also elsewhere on the board
/PWM_RE: R28.2, R30.1; also elsewhere on the board
/PWM_YE: R38.2, R40.1; also elsewhere on the board
/PWM_YR: R37.2, R39.1; also elsewhere on the board
GND: C29.2, C30.2, C33.2, C34.2; also elsewhere on the board
unnamed: C29.1, R29.2, R31.1
unnamed: C30.1, R30.2, R32.1
unnamed 77: C31.2, R33.2, R35.1; also elsewhere on the board
unnamed 78: C32.2, R34.2, R36.1; also elsewhere on the board
unnamed: C33.1, R39.2, R41.1
unnamed: C34.1, R40.2, R42.1
unnamed 81: C35.2, R43.2, R45.1; also elsewhere on the board
unnamed 82: C36.2, R44.2, R46.1; also elsewhere on the board
unnamed 140: C36.1, R42.2, R44.1; also elsewhere on the board
unnamed 141: C35.1, R41.2, R43.1; also elsewhere on the board
unnamed 144: C31.1, R31.2, R33.1; also elsewhere on the board
unnamed 145: C32.1, R32.2, R34.1; also elsewhere on the board

Notes on the sheet:
1.1V
Run from +/-12V
FDAI needles: 180 or 260 ohms. The full-deflection drive signal is roughly +/- 3V, but they are all slightly different. So 15 mA should be enough. 6 needles total.
INPUT: 0 to 3.3V (PWM)

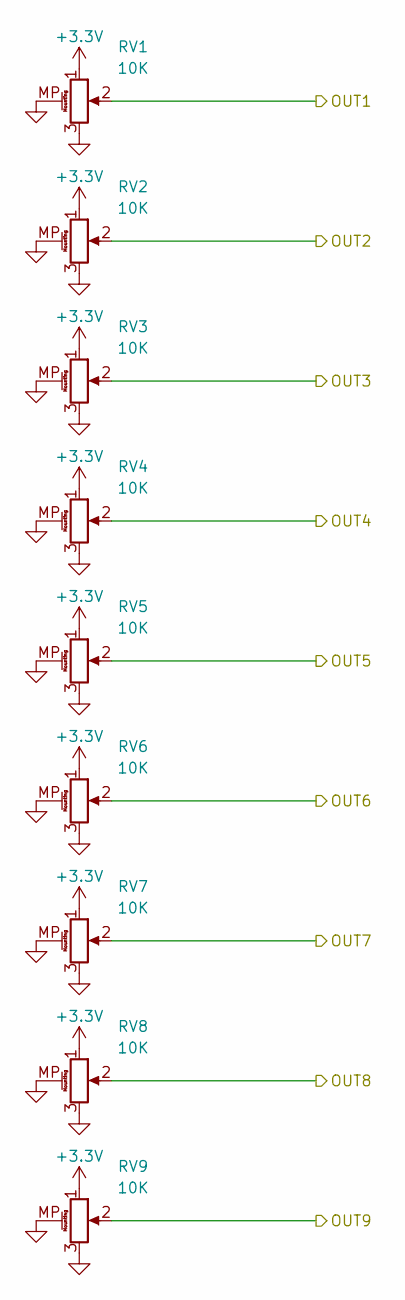
[picture p21: schematic Pots.kicad_sch]

Parts:
RV1, RV2, RV3, RV4, RV5, RV6, RV7, RV8, RV9: 10K; BOURNS_PTV09A_H; MPN PTV09A4030FB103; Mouser 652-PTV09A4030FB103

Connections:
+3.3V: RV1.1, RV2.1, RV3.1, RV4.1, RV5.1, RV6.1, RV7.1, RV8.1, RV9.1; also elsewhere on the board
/Pots/OUT1: RV1.2; also elsewhere on the board
/Pots/OUT2: RV2.2; also elsewhere on the board
/Pots/OUT3: RV3.2; also elsewhere on the board
/Pots/OUT4: RV4.2; also elsewhere on the board
/Pots/OUT5: RV5.2; also elsewhere on the board
/Pots/OUT6: RV6.2; also elsewhere on the board
/Pots/OUT7: RV7.2; also elsewhere on the board
/Pots/OUT8: RV8.2; also elsewhere on the board
/Pots/OUT9: RV9.2; also elsewhere on the board
GND: RV1.3, RV1.MP (MountPin), RV2.3, RV2.MP (MountPin), RV3.3, RV3.MP (MountPin), RV4.3, RV4.MP (MountPin), RV5.3, RV5.MP (MountPin), RV6.3, RV6.MP (MountPin), RV7.3, RV7.MP (MountPin), RV8.3, RV8.MP (MountPin), RV9.3, RV9.MP (MountPin); also elsewhere on the board

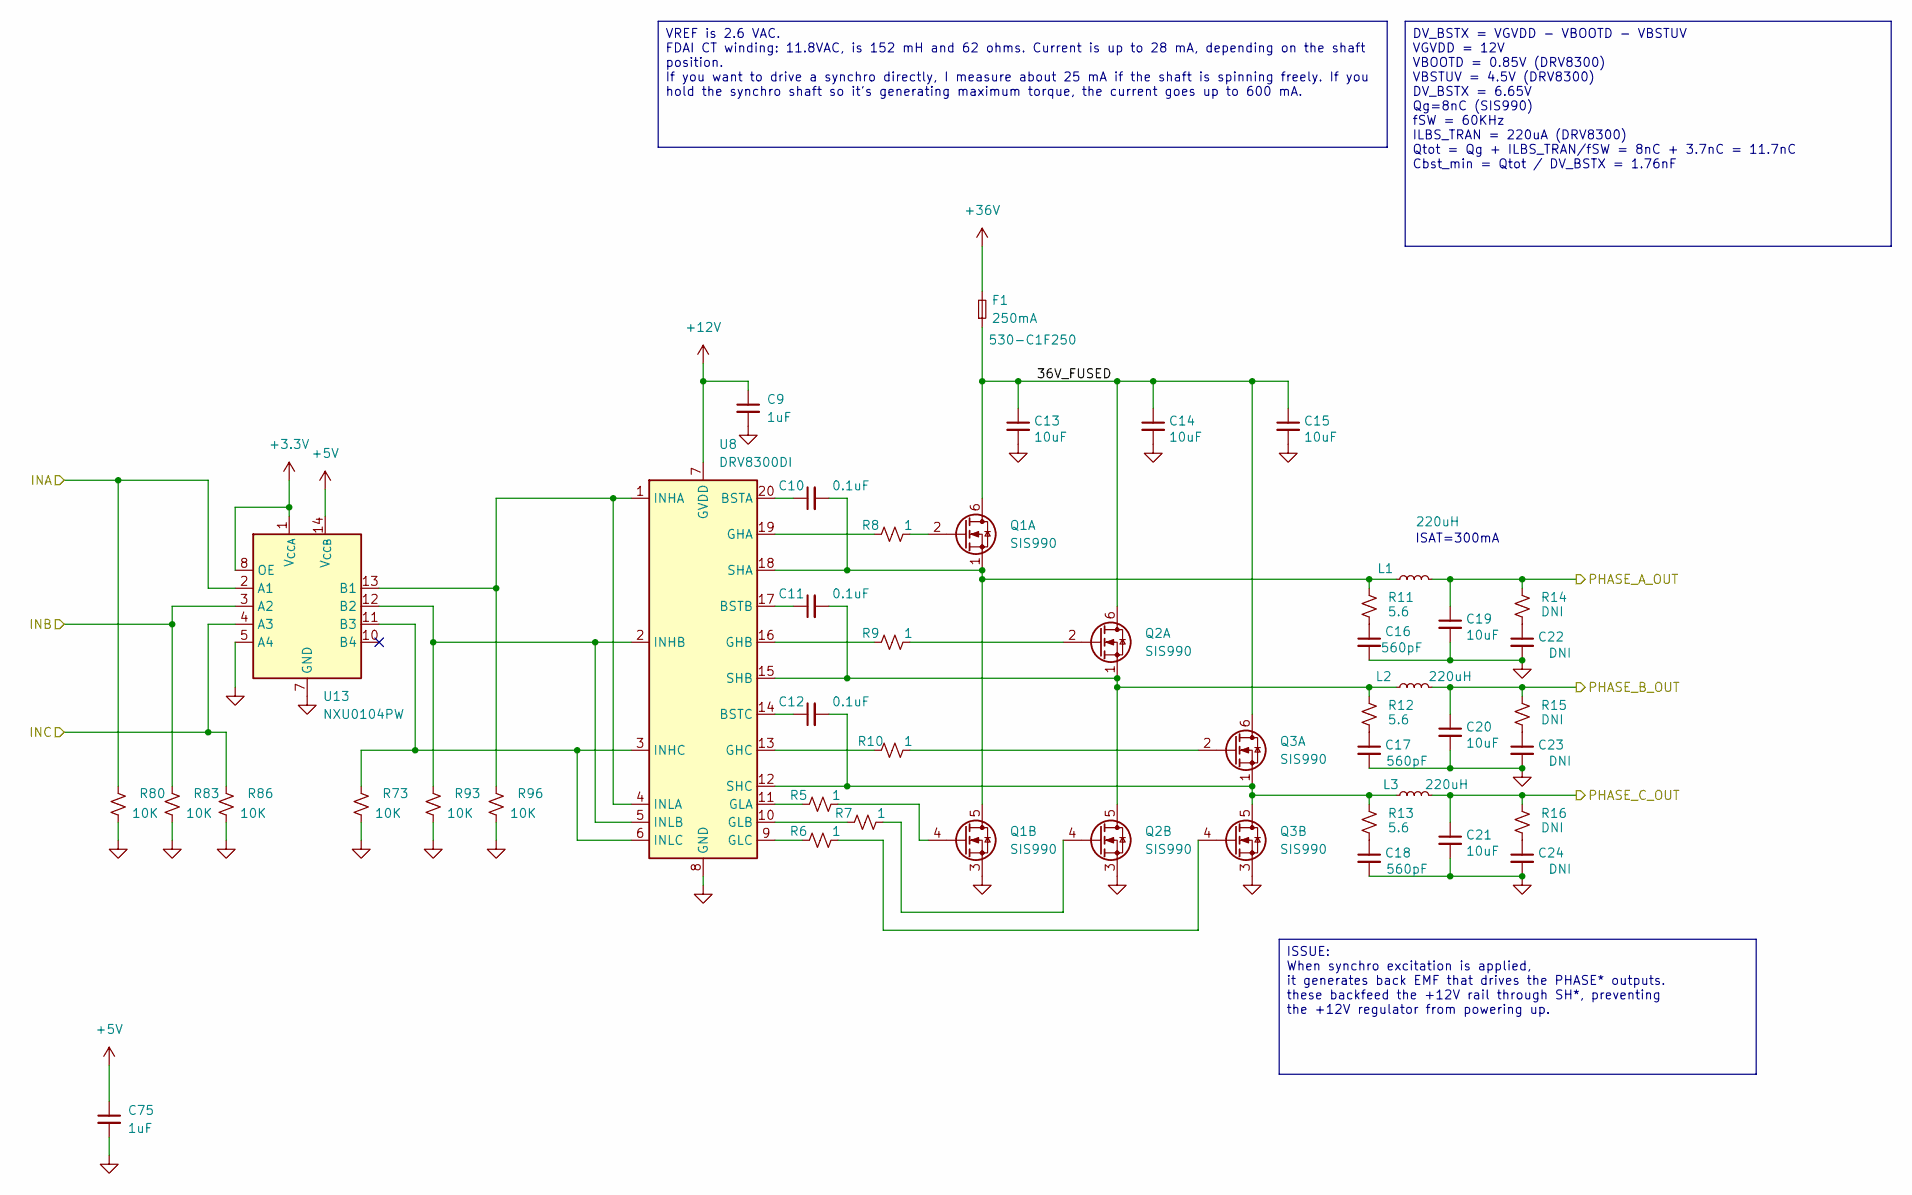
[picture p22: schematic SingleSynchroDriver.kicad_sch]

Parts:
C9, C75: 1uF; CAPC2012X55
C10, C11, C12: 0.1uF; CAPC1608X100
C13, C14, C15, C19, C20, C21: 10uF; C_1206_3216Metric; MPN CL31A106KBHNNNE; Mouser 187-CL31A106KBHNNNE
C16, C17, C18: 560pF; CAPC2012X55
C22, C23, C24: DNI; CAPC2012X55
F1: 250mA; Fuse_1206_3216Metric_Pad1.42x1.75mm_HandSolder; Mouser 530-C1F250
L1, L2, L3: 220uH; L_7.3x7.3_H3.5; MPN B82472G4224M000; Mouser 871-B82472G4224M
Q1, Q2, Q3: SIS990; Vishay_PowerPAK_1212-8_Dual; Mouser 78-SIS990DN-T1-GE3
R5, R6, R7, R8, R9, R10: 1; RESC1608X55
R11, R12, R13: 5.6; RESC2012X55
R14, R15, R16: DNI; RESC2012X55
R73, R80, R83, R86, R93, R96: 10K; RESC1608X55
U8: DRV8300DI; TSOP65P640X110-20; Mouser 595-DRV8300DIPWR
U13: NXU0104PW; TSSOP-14_4.4x5mm_P0.65mm

Connections:
+3.3V: U13.1 (V_{CCA}), U13.8 (OE); also elsewhere on the board
+5V: C75.1, U13.14 (V_{CCB}); also elsewhere on the board
+12V: C9.1, U8.7 (GVDD); also elsewhere on the board
+36V: F1.2; also elsewhere on the board
/PWM_R0: R80.2, U13.2 (A1); also elsewhere on the board
/PWM_R1: R83.2, U13.3 (A2); also elsewhere on the board
/PWM_R2: R86.2, U13.4 (A3); also elsewhere on the board
/SingleSynchroDriver1/36V_FUSED: C13.1, C14.1, C15.1, F1.1, Q1.6 (D), Q2.6 (D), Q3.6 (D)
/SingleSynchroDriver1/PHASE_A_OUT: C19.1, L1.2, R14.1; also elsewhere on the board
/SingleSynchroDriver1/PHASE_B_OUT: C20.1, L2.2, R15.1; also elsewhere on the board
/SingleSynchroDriver1/PHASE_C_OUT: C21.1, L3.2, R16.1; also elsewhere on the board
GND: C9.2, C13.2, C14.2, C15.2, C16.2, C17.2, C18.2, C19.2, C20.2, C21.2, C22.2, C23.2, C24.2, C75.2, Q1.3 (S), Q2.3 (S), Q3.3 (S), R73.1, R80.1, R83.1, R86.1, R93.1, R96.1, U8.8 (GND), U13.5 (A4), U13.7 (GND); also elsewhere on the board
unnamed: C16.1, R11.2
unnamed: C17.1, R12.2
unnamed: C18.1, R13.2
unnamed: C22.1, R14.2
unnamed: C23.1, R15.2
unnamed: C24.1, R16.2
unnamed: Q1.2 (G), R8.2
unnamed: C10.2, L1.1, Q1.1 (S), Q1.5 (D), R11.1, U8.18 (SHA)
unnamed: Q1.4 (G), R5.2
unnamed: Q2.2 (G), R9.2
unnamed: C11.2, L2.1, Q2.1 (S), Q2.5 (D), R12.1, U8.15 (SHB)
unnamed: Q2.4 (G), R7.2
unnamed: Q3.2 (G), R10.2
unnamed: C12.2, L3.1, Q3.1 (S), Q3.5 (D), R13.1, U8.12 (SHC)
unnamed: Q3.4 (G), R6.2
unnamed: C10.1, U8.20 (BSTA)
unnamed: C11.1, U8.17 (BSTB)
unnamed: C12.1, U8.14 (BSTC)
unnamed: R8.1, U8.19 (GHA)
unnamed: R9.1, U8.16 (GHB)
unnamed: R10.1, U8.13 (GHC)
unnamed: R5.1, U8.11 (GLA)
unnamed: R7.1, U8.10 (GLB)
unnamed: R6.1, U8.9 (GLC)
unnamed: R96.2, U8.1 (INHA), U8.4 (INLA), U13.13 (B1)
unnamed: R93.2, U8.2 (INHB), U8.5 (INLB), U13.12 (B2)
unnamed: R73.2, U8.3 (INHC), U8.6 (INLC), U13.11 (B3)

Parts of its further copies:
C37, C53, C76, C77: 1uF; CAPC2012X55
C38, C39, C40, C54, C55, C56: 0.1uF; CAPC1608X100
C41, C42, C43, C47, C48, C49, C57, C58, C59, C63, C64, C65: 10uF; C_1206_3216Metric; MPN CL31A106KBHNNNE; Mouser 187-CL31A106KBHNNNE
C44, C45, C46, C60, C61, C62: 560pF; CAPC2012X55
C50, C51, C52, C66, C67, C68: DNI; CAPC2012X55
F2, F3: 250mA; Fuse_1206_3216Metric_Pad1.42x1.75mm_HandSolder; Mouser 530-C1F250
L4, L5, L6, L7, L8, L9: 220uH; L_7.3x7.3_H3.5; MPN B82472G4224M000; Mouser 871-B82472G4224M
Q4, Q5, Q6, Q7, Q8, Q9: SIS990; Vishay_PowerPAK_1212-8_Dual; Mouser 78-SIS990DN-T1-GE3
R47, R48, R49, R50, R51, R52, R59, R60, R61, R62, R63, R64: 1; RESC1608X55
R53, R54, R55, R65, R66, R67: 5.6; RESC2012X55
R56, R57, R58, R68, R69, R70: DNI; RESC2012X55
R78, R79, R81, R82, R84, R85, R91, R92, R94, R95, R97, R98: 10K; RESC1608X55
U9, U11: DRV8300DI; TSOP65P640X110-20; Mouser 595-DRV8300DIPWR
U14, U15: NXU0104PW; TSSOP-14_4.4x5mm_P0.65mm

Connections of its further copies:
+3.3V: U14.1 (V_{CCA}), U14.8 (OE), U15.1 (V_{CCA}), U15.8 (OE); also elsewhere on the board
+5V: C76.1, C77.1, U14.14 (V_{CCB}), U15.14 (V_{CCB}); also elsewhere on the board
+12V: C37.1, C53.1, U9.7 (GVDD), U11.7 (GVDD); also elsewhere on the board
+36V: F2.2, F3.2; also elsewhere on the board
/PWM_P0: R81.2, U14.2 (A1); also elsewhere on the board
/PWM_P1: R84.2, U14.3 (A2); also elsewhere on the board
/PWM_P2: R91.2, U14.4 (A3); also elsewhere on the board
/PWM_Y0: R82.2, U15.2 (A1); also elsewhere on the board
/PWM_Y1: R85.2, U15.3 (A2); also elsewhere on the board
/PWM_Y2: R92.2, U15.4 (A3); also elsewhere on the board
/SingleSynchroDriver2/36V_FUSED: C41.1, C42.1, C43.1, F2.1, Q4.6 (D), Q5.6 (D), Q6.6 (D)
/SingleSynchroDriver2/PHASE_A_OUT: C47.1, L4.2, R56.1; also elsewhere on the board
/SingleSynchroDriver2/PHASE_B_OUT: C48.1, L5.2, R57.1; also elsewhere on the board
/SingleSynchroDriver2/PHASE_C_OUT: C49.1, L6.2, R58.1; also elsewhere on the board
/SingleSynchroDriver3/36V_FUSED: C57.1, C58.1, C59.1, F3.1, Q7.6 (D), Q8.6 (D), Q9.6 (D)
/SingleSynchroDriver3/PHASE_A_OUT: C63.1, L7.2, R68.1; also elsewhere on the board
/SingleSynchroDriver3/PHASE_B_OUT: C64.1, L8.2, R69.1; also elsewhere on the board
/SingleSynchroDriver3/PHASE_C_OUT: C65.1, L9.2, R70.1; also elsewhere on the board
GND: C37.2, C41.2, C42.2, C43.2, C44.2, C45.2, C46.2, C47.2, C48.2, C49.2, C50.2, C51.2, C52.2, C53.2, C57.2, C58.2, C59.2, C60.2, C61.2, C62.2, C63.2, C64.2, C65.2, C66.2, C67.2, C68.2, C76.2, C77.2, Q4.3 (S), Q5.3 (S), Q6.3 (S), Q7.3 (S), Q8.3 (S), Q9.3 (S), R78.1, R79.1, R81.1, R82.1, R84.1, R85.1, R91.1, R92.1, R94.1, R95.1, R97.1, R98.1, U9.8 (GND), U11.8 (GND), U14.5 (A4), U14.7 (GND), U15.5 (A4), U15.7 (GND); also elsewhere on the board
unnamed: C44.1, R53.2
unnamed: C45.1, R54.2
unnamed: C46.1, R55.2
unnamed: C50.1, R56.2
unnamed: C51.1, R57.2
unnamed: C52.1, R58.2
unnamed: C60.1, R65.2
unnamed: C61.1, R66.2
unnamed: C62.1, R67.2
unnamed: C66.1, R68.2
unnamed: C67.1, R69.2
unnamed: C68.1, R70.2
unnamed: Q4.2 (G), R50.2
unnamed: C38.2, L4.1, Q4.1 (S), Q4.5 (D), R53.1, U9.18 (SHA)
unnamed: Q4.4 (G), R47.2
unnamed: Q5.2 (G), R51.2
unnamed: C39.2, L5.1, Q5.1 (S), Q5.5 (D), R54.1, U9.15 (SHB)
unnamed: Q5.4 (G), R49.2
unnamed: Q6.2 (G), R52.2
unnamed: C40.2, L6.1, Q6.1 (S), Q6.5 (D), R55.1, U9.12 (SHC)
unnamed: Q6.4 (G), R48.2
unnamed: Q7.2 (G), R62.2
unnamed: C54.2, L7.1, Q7.1 (S), Q7.5 (D), R65.1, U11.18 (SHA)
unnamed: Q7.4 (G), R59.2
unnamed: Q8.2 (G), R63.2
unnamed: C55.2, L8.1, Q8.1 (S), Q8.5 (D), R66.1, U11.15 (SHB)
unnamed: Q8.4 (G), R61.2
unnamed: Q9.2 (G), R64.2
unnamed: C56.2, L9.1, Q9.1 (S), Q9.5 (D), R67.1, U11.12 (SHC)
unnamed: Q9.4 (G), R60.2
unnamed: C38.1, U9.20 (BSTA)
unnamed: C39.1, U9.17 (BSTB)
unnamed: C40.1, U9.14 (BSTC)
unnamed: R50.1, U9.19 (GHA)
unnamed: R51.1, U9.16 (GHB)
unnamed: R52.1, U9.13 (GHC)
unnamed: R47.1, U9.11 (GLA)
unnamed: R49.1, U9.10 (GLB)
unnamed: R48.1, U9.9 (GLC)
unnamed: C54.1, U11.20 (BSTA)
unnamed: C55.1, U11.17 (BSTB)
unnamed: C56.1, U11.14 (BSTC)
unnamed: R62.1, U11.19 (GHA)
unnamed: R63.1, U11.16 (GHB)
unnamed: R64.1, U11.13 (GHC)
unnamed: R59.1, U11.11 (GLA)
unnamed: R61.1, U11.10 (GLB)
unnamed: R60.1, U11.9 (GLC)
unnamed: R98.2, U11.1 (INHA), U11.4 (INLA), U15.13 (B1)
unnamed: R95.2, U11.2 (INHB), U11.5 (INLB), U15.12 (B2)
unnamed: R79.2, U11.3 (INHC), U11.6 (INLC), U15.11 (B3)
unnamed: R97.2, U9.1 (INHA), U9.4 (INLA), U14.13 (B1)
unnamed: R94.2, U9.2 (INHB), U9.5 (INLB), U14.12 (B2)
unnamed: R78.2, U9.3 (INHC), U9.6 (INLC), U14.11 (B3)

Notes on the sheet:
ISAT=300mA
DV_BSTX = VGVDD - VBOOTD - VBSTUV VGVDD = 12V VBOOTD = 0.85V (DRV8300) VBSTUV = 4.5V (DRV8300) DV_BSTX = 6.65V Qg=8nC (SIS990) fSW = 60KHz ILBS_TRAN = 220uA (DRV8300) Qtot = Qg + ILBS_TRAN/fSW = 8nC + 3.7nC = 11.7nC Cbst_min = Qtot / DV_BSTX = 1.76nF
VREF is 2.6 VAC. FDAI CT winding: 11.8VAC, is 152 mH and 62 ohms. Current is up to 28 mA, depending on the shaft position. If you want to drive a synchro directly, I measure about 25 mA if the shaft is spinning freely. If you hold the synchro shaft so it's generating maximum torque, the current goe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
ISSUE: When synchro excitation is applied, it generates back EMF that drives the PHASE* outputs. these backfeed the +12V rail through SH*, preventing the +12V regulator from powering up.

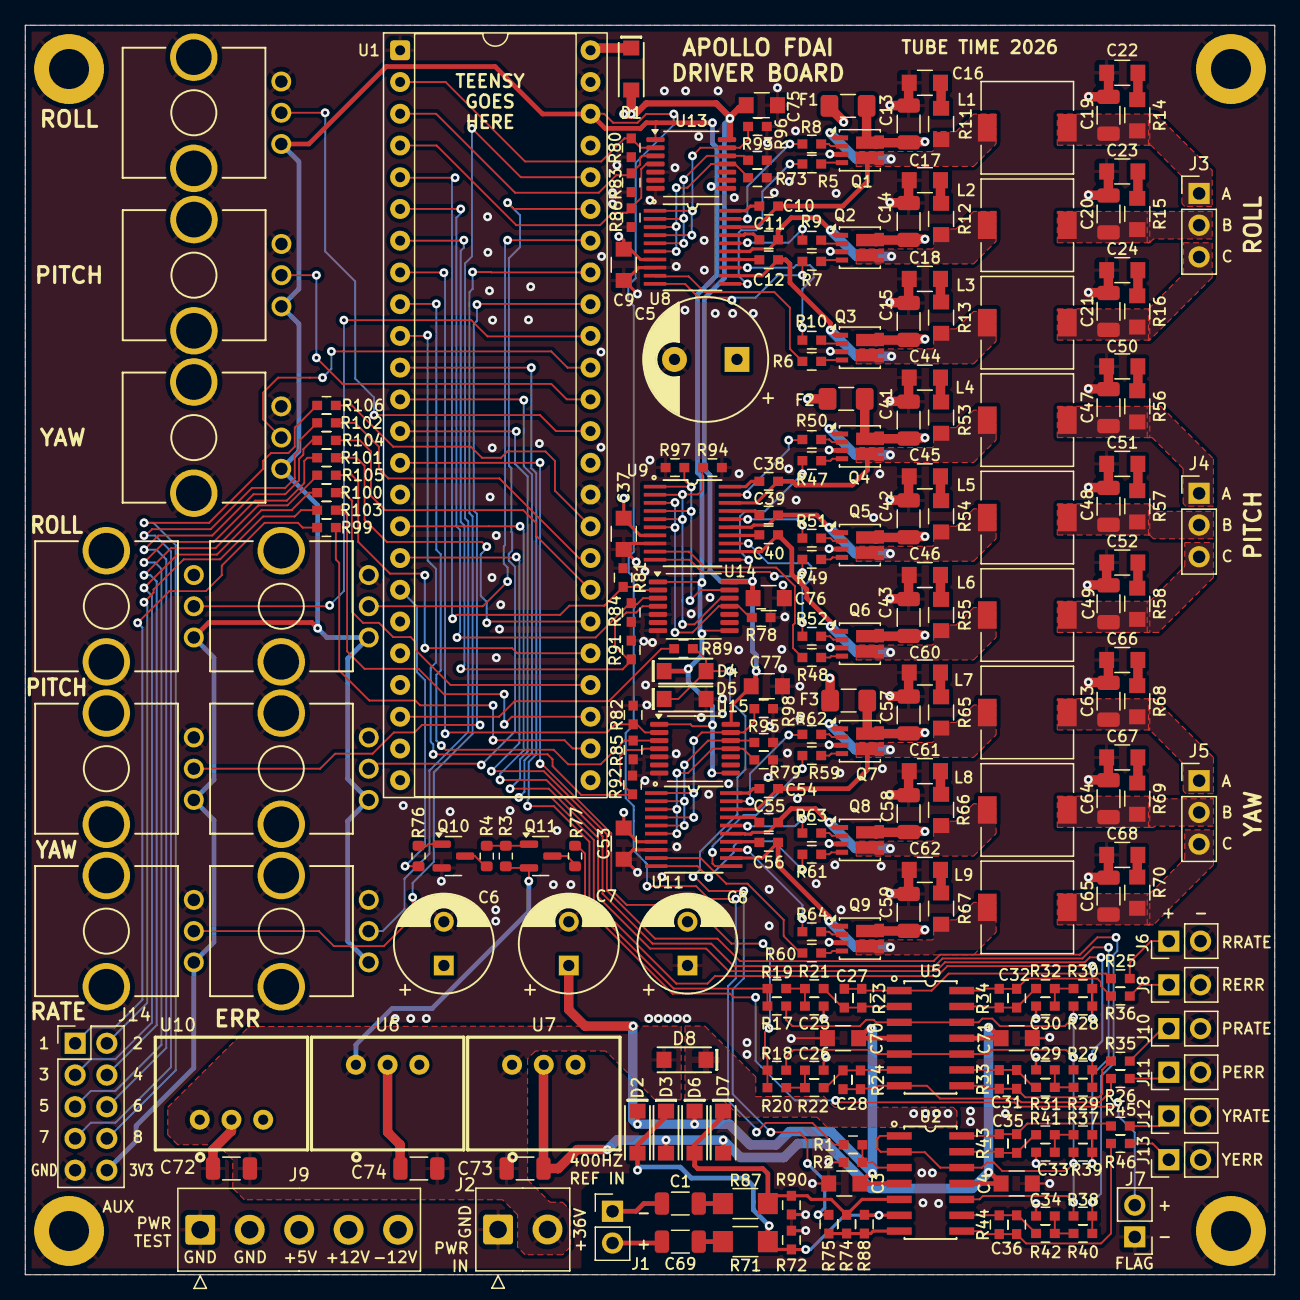
[picture p23: board SynchroDriverD.kicad_pcb from above]

Board: 2 copper layers, 100.0 x 100.0 mm, 252 parts (0 on the bottom side), 182 nets.
