schlae/SynchroDriver/SynchroDriverDS/SynchroDriverDS.kicad_pcb

## KiCad design SynchroDriverDS/SynchroDriverDS.kicad_pcb (2025-08-07)

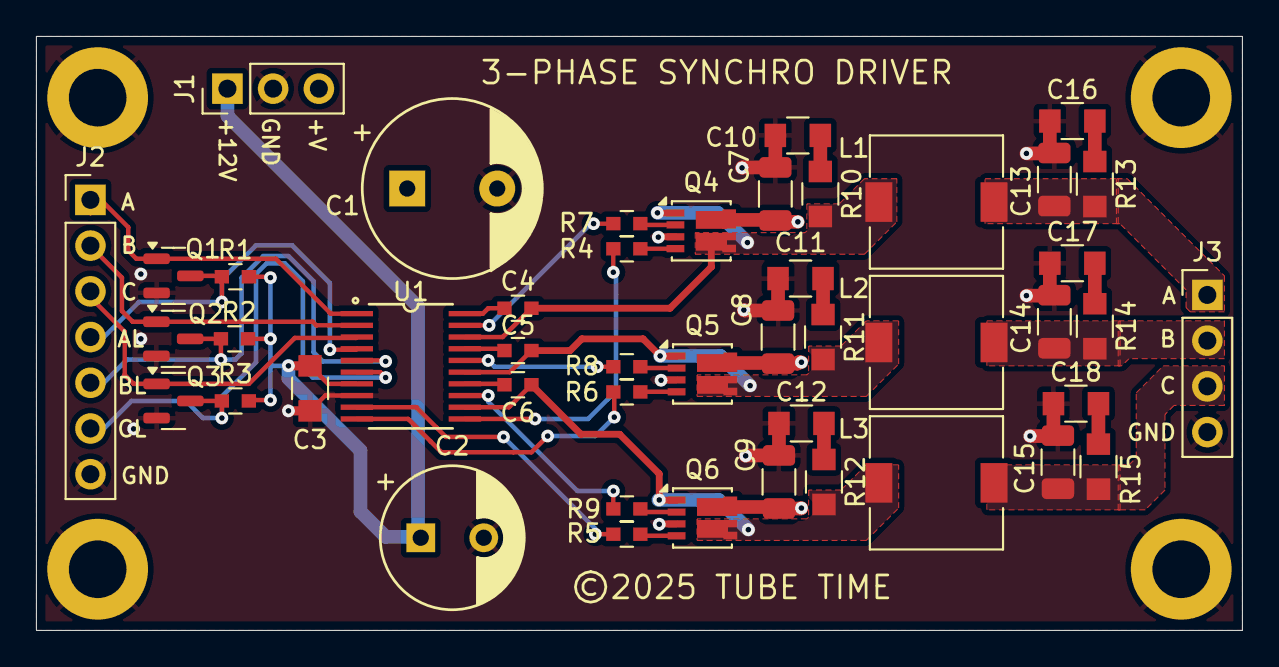
[picture p24: board SynchroDriverDS.kicad_pcb from above]

Board: 2 copper layers, 67.0 x 33.0 mm, 50 parts (0 on the bottom side), 36 nets.

Parts:
C1: 1000uF; CAPAE500P1000X1500
C2: 100uF; CAPAE350P800X700
C3: 1uF; CAPC2012X55
C4, C5, C6: 0.1uF; CAPC1608X100
C7, C8, C9, C13, C14, C15: 10uF; C_1206_3216Metric
C10, C11, C12, C16, C17, C18: DNI; CAPC2012X55
H1, H2, H3, H4: MountingHole_Pad; MountingHole_3.2mm_M3_DIN965_Pad
J1: POWER; PinHeader_1x03_P2.54mm_Vertical
J2: CTRL; PinHeader_1x07_P2.54mm_Vertical
J3: Conn_01x04; PinHeader_1x04_P2.54mm_Vertical
L1, L2, L3: 220uH; L_7.3x7.3_H3.5
Q1, Q2, Q3: 2N7002; SOT-23
Q4, Q5, Q6: SIS990; Vishay_PowerPAK_1212-8_Dual
R1, R2, R3: 4.7K; RESC1608X55
R4, R5, R6, R7, R8, R9: 1; RESC1608X55
R10, R11, R12, R13, R14, R15: DNI; RESC2012X55
U1: DRV8300; TSOP65P640X110-20

Connections:
+12V: C2.1, C3.1, J1.1, R1.2, R2.2, R3.2, U1.7 (GVDD)
+36V: C1.1, C7.1, C8.1, C9.1, J1.3, Q4.6 (D), Q5.6 (D), Q6.6 (D)
/SingleSynchroDriver/INA: J2.1, Q1.1 (G), U1.1 (INHA)
/SingleSynchroDriver/INAL: J2.4, Q1.3 (D), R1.1, U1.4 (INLA)
/SingleSynchroDriver/INB: J2.2, Q2.1 (G), U1.2 (INHB)
/SingleSynchroDriver/INBL: J2.5, Q2.3 (D), R2.1, U1.5 (INLB)
/SingleSynchroDriver/INC: J2.3, Q3.1 (G), U1.3 (INHC)
/SingleSynchroDriver/INCL: J2.6, Q3.3 (D), R3.1, U1.6 (INLC)
/SingleSynchroDriver/PHASE_A_OUT: C13.1, J3.1, L1.2, R13.1
/SingleSynchroDriver/PHASE_B_OUT: C14.1, J3.2, L2.2, R14.1
/SingleSynchroDriver/PHASE_C_OUT: C15.1, J3.3, L3.2, R15.1
GND: C1.2, C2.2, C3.2, C7.2, C8.2, C9.2, C10.2, C11.2, C12.2, C13.2, C14.2, C15.2, C16.2, C17.2, C18.2, H1.1, H2.1, H3.1, H4.1, J1.2, J2.7, J3.4, Q1.2 (S), Q2.2 (S), Q3.2 (S), Q4.3 (S), Q5.3 (S), Q6.3 (S), U1.8 (GND)
unnamed: C10.1, R10.2
unnamed: C11.1, R11.2
unnamed: C12.1, R12.2
unnamed: C16.1, R13.2
unnamed: C17.1, R14.2
unnamed: C18.1, R15.2
unnamed: Q4.2 (G), R7.2
unnamed: C4.2, L1.1, Q4.1 (S), Q4.5 (D), R10.1, U1.18 (SHA)
unnamed: Q4.4 (G), R4.2
unnamed: Q5.2 (G), R8.2
unnamed: C5.2, L2.1, Q5.1 (S), Q5.5 (D), R11.1, U1.15 (SHB)
unnamed: Q5.4 (G), R6.2
unnamed: Q6.2 (G), R9.2
unnamed: C6.2, L3.1, Q6.1 (S), Q6.5 (D), R12.1, U1.12 (SHC)
unnamed: Q6.4 (G), R5.2
unnamed: C4.1, U1.20 (BSTA)
unnamed: C5.1, U1.17 (BSTB)
unnamed: C6.1, U1.14 (BSTC)
unnamed: R7.1, U1.19 (GHA)
unnamed: R8.1, U1.16 (GHB)
unnamed: R9.1, U1.13 (GHC)
unnamed: R4.1, U1.11 (GLA)
unnamed: R6.1, U1.10 (GLB)
unnamed: R5.1, U1.9 (GLC)
