schlae/SynchroDriver/SynchroDriverAS/SynchroDriverAS.kicad_pcb

## KiCad design SynchroDriverAS/SynchroDriverAS.kicad_pcb (2025-08-07)

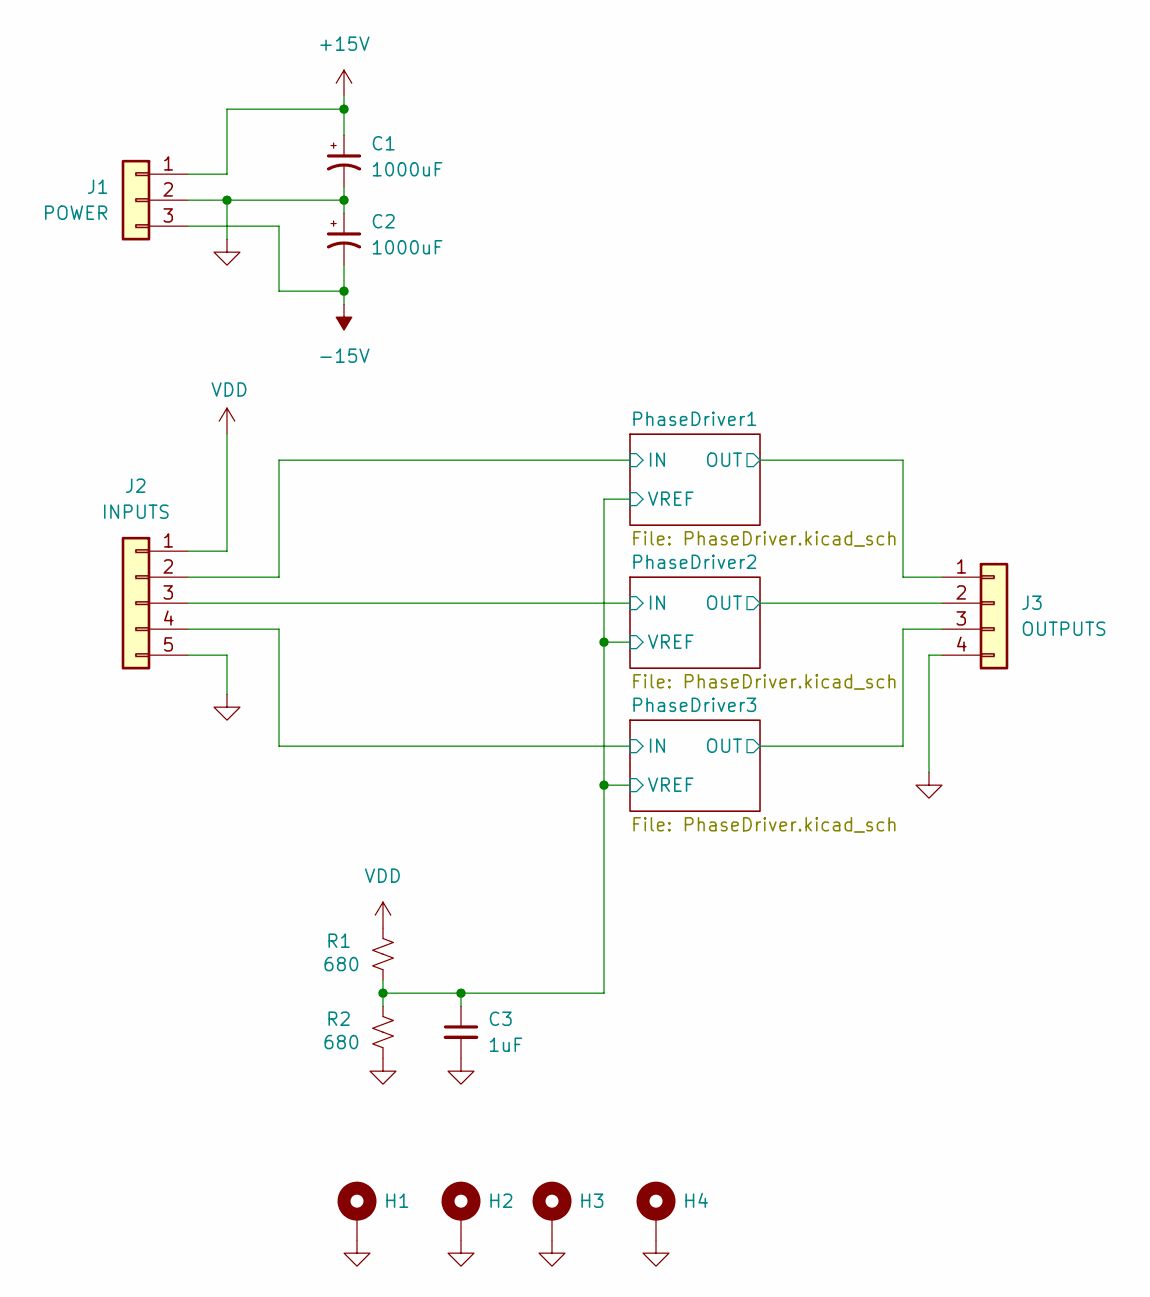
[picture p25: schematic SynchroDriverAS.kicad_sch]

Parts:
C1, C2: 1000uF; CAPAE500P1000X1500
C3: 1uF; CAPC2012X55
H1, H2, H3, H4: MountingHole_Pad; MountingHole_3.2mm_M3_DIN965_Pad
J1: POWER; PinHeader_1x03_P2.54mm_Vertical
J2: INPUTS; PinHeader_1x05_P2.54mm_Vertical
J3: OUTPUTS; PinHeader_1x04_P2.54mm_Vertical
R1, R2: 680; RESC1608X55

Connections:
+15V: C1.1, J1.1; also elsewhere on the board
-15V: C2.2, J1.3; also elsewhere on the board
/PhaseDriver1/IN: J2.2; also elsewhere on the board
/PhaseDriver1/OUT: J3.1; also elsewhere on the board
/PhaseDriver1/VREF: C3.1, R1.1, R2.2; also elsewhere on the board
/PhaseDriver2/IN: J2.3; also elsewhere on the board
/PhaseDriver2/OUT: J3.2; also elsewhere on the board
/PhaseDriver3/IN: J2.4; also elsewhere on the board
/PhaseDriver3/OUT: J3.3; also elsewhere on the board
GND: C1.2, C2.1, C3.2, H1.1, H2.1, H3.1, H4.1, J1.2, J2.5, J3.4, R2.1; also elsewhere on the board
VDD: J2.1, R1.2

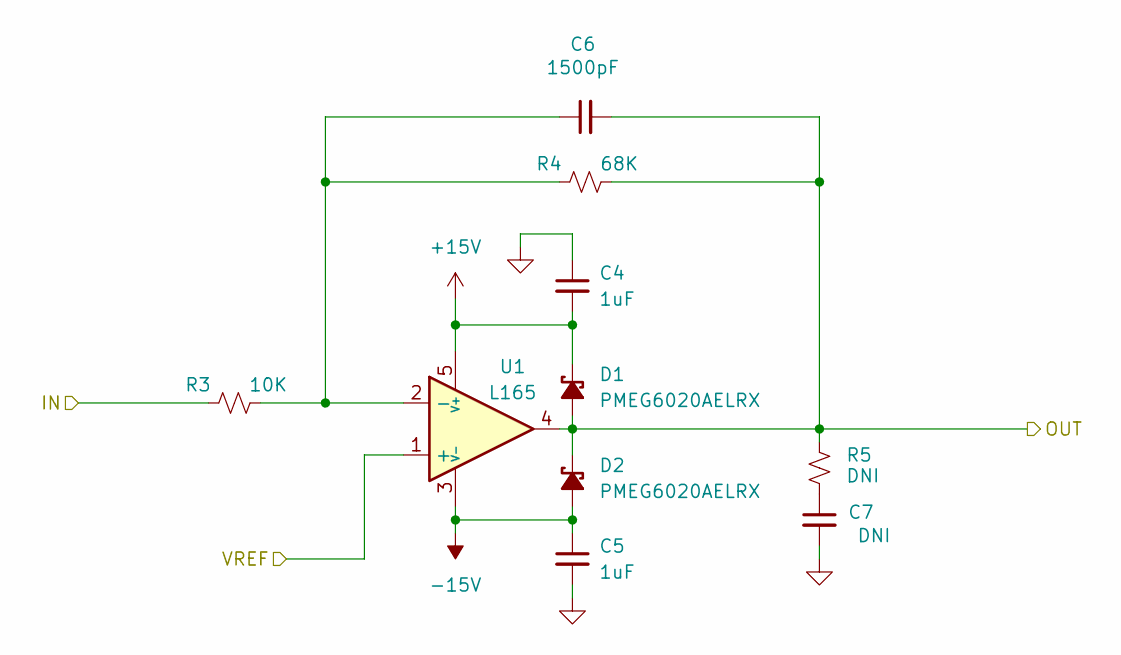
[picture p26: schematic PhaseDriver.kicad_sch]

Parts:
C4, C5: 1uF; CAPC2012X55
C6: 1500pF; CAPC1608X100
C7: DNI; CAPC2012X55
D1, D2: PMEG6020AELRX; SOD3716X117; Mouser 771-PMEG10010ELRX
R3: 10K; RESC1608X55
R4: 68K; RESC1608X55
R5: DNI; RESC2012X55
U1: L165; TO-220-5_Stagger_Vertical_L165

Connections:
+15V: C4.2, D1.1 (K), U1.5 (V+); also elsewhere on the board
-15V: C5.1, D2.2 (A), U1.3 (V-); also elsewhere on the board
/PhaseDriver1/IN: R3.1; also elsewhere on the board
/PhaseDriver1/OUT: C6.2, D1.2 (A), D2.1 (K), R4.2, R5.1, U1.4; also elsewhere on the board
/PhaseDriver1/VREF: U1.1 (+); also elsewhere on the board
GND: C4.1, C5.2, C7.2; also elsewhere on the board
unnamed: C7.1, R5.2
unnamed: C6.1, R3.2, R4.1, U1.2 (-)

Parts of its further copies:
C8, C9, C12, C13: 1uF; CAPC2012X55
C10, C14: 1500pF; CAPC1608X100
C11, C15: DNI; CAPC2012X55
D3, D4, D5, D6: PMEG6020AELRX; SOD3716X117; Mouser 771-PMEG10010ELRX
R6, R9: 10K; RESC1608X55
R7, R10: 68K; RESC1608X55
R8, R11: DNI; RESC2012X55
U2, U3: L165; TO-220-5_Stagger_Vertical_L165

Connections of its further copies:
+15V: C8.2, C12.2, D3.1 (K), D5.1 (K), U2.5 (V+), U3.5 (V+); also elsewhere on the board
-15V: C9.1, C13.1, D4.2 (A), D6.2 (A), U2.3 (V-), U3.3 (V-); also elsewhere on the board
/PhaseDriver1/VREF: U2.1 (+), U3.1 (+); also elsewhere on the board
/PhaseDriver2/IN: R6.1; also elsewhere on the board
/PhaseDriver2/OUT: C10.2, D3.2 (A), D4.1 (K), R7.2, R8.1, U2.4; also elsewhere on the board
/PhaseDriver3/IN: R9.1; also elsewhere on the board
/PhaseDriver3/OUT: C14.2, D5.2 (A), D6.1 (K), R10.2, R11.1, U3.4; also elsewhere on the board
GND: C8.1, C9.2, C11.2, C12.1, C13.2, C15.2; also elsewhere on the board
unnamed: C11.1, R8.2
unnamed: C15.1, R11.2
unnamed: C10.1, R6.2, R7.1, U2.2 (-)
unnamed: C14.1, R9.2, R10.1, U3.2 (-)

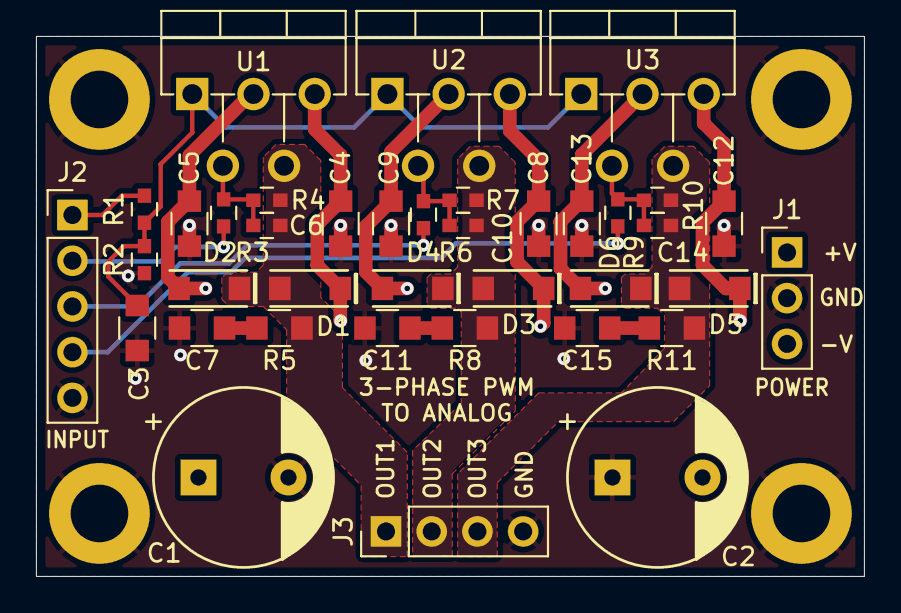
[picture p27: board SynchroDriverAS.kicad_pcb from above]

Board: 2 copper layers, 46.0 x 30.0 mm, 42 parts (0 on the bottom side), 17 nets.
