schlae/SynchroDriver/SynchroDriverD/firmware/flightpath/rpy.cpp

// Two minutes of flight data with 10 entries per second
// Each entry is roll, pitch, yaw, all in tenths of degrees

int data[] = {
-20, 121, 635, -20, 122, 635, -20, 121, 635, -20, 121, 636, -20, 120, 636, -20, 116, 637, -22, 108, 638, -22, 108, 639, -24, 104, 643, -20, 107, 647, // 2022-11-01 17:51:57.57
-12, 106, 653, -8, 100, 657, -5, 124, 660, 1, 144, 665, -12, 158, 667, 27, 171, 671, -8, 176, 671, -9, 179, 671, -6, 181, 671, -4, 186, 670, // 2022-11-01 17:51:58.57
-4, 189, 670, -3, 193, 670, -3, 195, 670, -2, 197, 671, -2, 198, 671, -1, 200, 671, -1, 200, 672, -1, 200, 672, 0, 200, 672, 0, 200, 673, // 2022-11-01 17:51:59.57
0, 201, 673, 0, 201, 673, 0, 202, 674, 0, 203, 674, -1, 203, 674, -37, 203, 673, -62, 203, 672, -83, 204, 669, -89, 205, 665, -90, 205, 658, // 2022-11-01 17:52:00.57
-82, 206, 652, -73, 206, 650, -60, 206, 646, -51, 206, 644, -40, 206, 642, -33, 207, 641, -25, 208, 639, -20, 209, 638, -13, 210, 638, -10, 211, 638, // 2022-11-01 17:52:01.57
-7, 211, 638, -5, 211, 638, -4, 211, 638, -3, 211, 638, -3, 211, 638, -3, 211, 638, -3, 209, 638, -3, 206, 638, -3, 200, 638, -3, 195, 638, // 2022-11-01 17:52:02.57
-2, 187, 638, -2, 181, 638, -2, 172, 638, -2, 166, 638, -2, 158, 638, -2, 153, 638, -2, 145, 638, -2, 141, 638, -2, 135, 638, -2, 131, 638, // 2022-11-01 17:52:03.57
-2, 126, 638, -2, 122, 638, -2, 118, 638, -1, 116, 638, 0, 113, 638, 0, 111, 638, 0, 108, 638, 0, 105, 639, 1, 103, 639, 1, 101, 639, // 2022-11-01 17:52:04.57
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
3, 1, 3226, 3, 3, 3226, 3, 5, 3226, 3, 6, 3226, 3, 9, 3226, 3, 10, 3227, 3, 12, 3227, 3, 14, 3227, 3, 16, 3226, 3, 18, 3226, // 2022-11-01 17:52:36.57
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
};
int len = sizeof(data) / sizeof(data[0]);
