schlae/SynchroDriver/(commit log)

2025-06-29 Ad flag drive circuit
    [FlagDriver.kicad_sch, NeedleDriver.kicad_sch, SingleSynchroDriver.kicad_sch, SynchroDriverD.kicad_pcb, SynchroDriverD.kicad_sch]
2025-07-06 PCB layout
    [SynchroDriverD.kicad_pcb]
2025-07-06 Mouser parts, layout changes
    [Pots.kicad_sch, SynchroDriverD.kicad_pcb]
2025-07-07 Complete layout
    [SynchroDriverD.kicad_pcb]
2025-07-07 Layout for analog 3-phase pcb
    [SynchroDriverAS.kicad_pcb]
2025-07-08 Update digital single synchro pcb
    [SynchroDriverDS.kicad_pcb, SynchroDriverDS.kicad_sch]
2025-07-13 Swap DRV8300 for DRV8300DI, change ref in
    [InputComparator.kicad_sch, SingleSynchroDriver.kicad_sch, SynchroDriverD.kicad_sch]
2025-07-17 Improve ref in, clearance for 115V
    [InputComparator.kicad_sch, SynchroDriverD.kicad_pcb, SynchroDriverD.kicad_sch, SynchroDriverDS.kicad_pcb]
2025-08-07 Fab out and add schematic pdf
    [SynchroDriverAS.kicad_pcb, SynchroDriverD.kicad_pcb, SynchroDriverDS.kicad_pcb]
2025-08-29 Tweaks after first build
    [FlagDriver.kicad_sch, InputComparator.kicad_sch, NeedleDriver.kicad_sch, SingleSynchroDriver.kicad_sch, SynchroDriverD.kicad_sch]
2025-09-08 Add Teensy firmware
2025-09-13 Firmware PWM frequency fix. Synchro bodge. Needle value changes
    [NeedleDriver.kicad_sch, SingleSynchroDriver.kicad_sch]
2025-09-13 Meter driver vref fix. Sync in gain fix.
    [InputComparator.kicad_sch, SynchroDriverD.kicad_sch]
2025-10-06 Move synchro.ino to subdirectory. The Arduino IDE requires the file to be in a directory with the same name.
2025-12-05 FDAI driver board program to get roll, pitch, and yaw from serial port.
2025-12-05 Program to parse flight log and send roll, pitch, and yaw over serial port.
2025-12-08 Handle optional trailing comma on yaw
2026-01-05 Add correction factors to the angles. Swap pitch and yaw and make yaw negative.
    [align.ino]
2026-01-05 Add angle adjustments to flightpath. Set initial yaw to 0 by subtracting yaw at start. Wait three seconds before starting flightpath.
2026-01-05 Fix interpolation glitch when angle wraps around. Formerly, interpolating between 359 degrees and 1 would go through 180. Now the interpolation will go the "short" way through 0.
    [flightpath.ino]
2026-03-14 add level shifter and fuses
2026-06-24 Wire up new level shifters, add motor diode
