schlae/SynchroDriver/(notices)

Notices in the files:
SynchroDriverAS/SynchroDriverAS.kicad_pcb:
©2025 TUBE TIME
